yolkytygyfse-a11y/pv-senselab/tests/hardware/README.md

# 硬件验证范围

先完成危害审查与限流方案，依次验证电源/回灌/接地、V/I 量程与静动态标定、PT100 故障、Modbus CRC/超时、MOSFET SOA/热、风扇故障、过流/过温、心跳/复位/断联、物理急停及清洁限位/堵转/互锁。

故障注入方法与注入源须经审查，不直接破坏唯一原型或超出仪表/器件范围。报告每项仪表、接线、条件、冻结阈值、原始日志和结果，未测即标未测。仅独立低压组件；禁止屋顶系统。当前无实测记录。

## 已购物料的前置验证（尚未执行）

- 不接 PV 功率通路，核对开发板、RS485 转 TTL、INA226、MAX31865 的供电/电平，记录 RS485 RO 电平、方向、参考地/隔离与终端，确认后接线。
- SM9569：按实物确认符合手册 DC12–24V 的限流供电与极性；读取实际配置/0x0000 原值，保存 CRC/超时/原帧，不写配置。向厂家确认倍率、响应、误差定义与校准依据后做参考对比。
- SM7820B：按正确手册核对DC5–24V及p.4线序；单独验证实际地址/9600/8N1和FC03双寄存器，再合并不同地址总线。参考核对倍率、负温补码与手册一count冲突、温湿度/故障/无效码；确认前null。验证CRC/异常/超时/迟到/背压/复位，保留原始证据，不自动写配置。
- PT100/MAX31865：类型已确认配套；验证线制/Rref/接触工艺，用标准电阻和温度参考完成两级验证，包含开短路测试，不能仅以有数值作为通过。
- INA226：核对最坏 Voc/Isc 与模块分流/端子/SOA/热/保护条件；先用受限参考源验证零点、增益/非线性、V/I 时间窗与负担，再决定是否适合正式扫描，不能仅凭 50W 标签接入。

2026-10-25 已完成手册内容/来源摘要和 SM9569 示例 CRC 的离线核对；无上电、总线通信、标定、PV 采集或清洁动作结果。

## GPIO 规划 P1 的验证步骤

对主板 INTERFACES.md 的 9 个候选 GPIO 做重复/保留脚/实际引出检查，核对 3.3V 轨、UART RO、I²C 上拉、PT100 线制/Rref 与 RS485 双仪表地址/串口/参考地。按文档分步独立通电并保留成功/失败证据。无 CAN 接线；PV/电子负载/执行器功率回路另审查，纸面检查不代替实物验收。
