yolkytygyfse-a11y/pv-senselab/paper/references/README.md

# 文献与技术资料

当前官方技术入口见 [BOM](../../docs/BOM.md) 以及各规格的对应来源；尚未建立研究文献库。后续核对作者、题名、年份、DOI/链接、实际支持的命题与访问/版本信息。

器件手册在设计冻结时记录版本与摘要；论文引用不得凭记忆捏造，不把官网产品参数作为整机实测证据。受许可限制的全文不随意提交，可保留可访问的索引。
