yolkytygyfse-a11y/pv-senselab/hardware/pv-electronic-load/pcb/README.md

# 负载板 PCB 源目录

当前无 PCB、Gerber 或制造完成记录。必须先完成原理图评审与 TBD-17 机械/加工约束，确认散热器、绝缘/固定、风道和测试点再布局。

重点核对大电流环路、分流 Kelvin、模拟环/门极稳定、热传感位置、急停开断、跨板参考、温升与可触及热表面。提交真实源、DRC/人工审查、BOM/热依据与制造输出的版本关联后才可验收。
