yolkytygyfse-a11y/pv-senselab/hardware/pv-electronic-load/schematics/README.md

# 负载板原理图源目录

当前无原理图。后续保存真实立创EDA工程、版本/库与手册依据、网表/PDF 和审查记录；本文件不代表电路已完成。

绘制前核对 [模块规格](../MODULE_SPEC.md)、[接口](../INTERFACES.md)、线性 SOA/热预算、电源/欠压、硬件限流/过温/急停/心跳、单 FET 短路开断及端点方案。量程、SOA、热耗散、接地、保护和校准全部有依据后才可签核。
