yolkytygyfse-a11y/pv-senselab/hardware/pv-sensing-board/pcb/README.md

# 主板 PCB 源目录

当前无 PCB 或制造文件。待原理图通过评审、PCB 尺寸/层数/铜厚/电流/间距/天线与机械约束（TBD-17）冻结后，在此保存真实立创EDA源与必要审查记录。

布板核对采样 Kelvin、模拟参考、功率/电机回流隔离、USB/RS485 保护、热源距离和校准测试点。制造输出必须绑定源版本、BOM 与 DRC/人工审查；未经审查不生成可投产结论。
