yolkytygyfse-a11y/pv-senselab/hardware/pv-sensing-board/schematics/README.md

# 主板原理图源目录

当前无原理图。后续在立创EDA绘制真实工程并保存到本目录，同时登记工具/库版本、工程 ID、文件摘要和审查结果。禁止放入空白 EDA 文件冒充成果。

绘制前关闭 [模块规格](../MODULE_SPEC.md) 相关 TBD，核对 [接口](../INTERFACES.md)；交付电源树、测量边界、器件手册与引脚核对、量程/误差、保护/接地及校准点。ERC 和人工审查均无阻塞后才能转 PCB。
