yolkytygyfse-a11y/pv-senselab/software/src/pv_senselab/README.md

# Python 代码职责（尚未实现）

计划按实际需要在同一个小包内组织：串口会话与协议校验、追加归档/manifest、任务编排和清洁授权、特征提取及离线分析入口。当前没有 `__init__.py` 或占位函数，不宣称可 import/run。

主机须先准备持久化再 ARM，原始字节优先保存；磁盘失败/背压请求停机且标明未确认设备状态。stop 的安全性不能依赖此包一直运行。scan/action 的 ACK 与终止事件分开处理，清洁不得自动重试。

特征处理保留原曲线和排除理由；模型拟合引用 `models/` 的实现职责与版本，避免创建第二套不可追溯算法。
