yolkytygyfse-a11y/pv-senselab/docs/HARDWARE_SPEC.md

# 硬件总规格与未决项登记册

版本：0.2；日期：2026-10-25；状态：原理图前规格草案，已补充手册核对与采购记录。所有 TBD 均未批准用于接线或上电。

采购核对更新（2026-10-20）：用户报告已购 RS485 辐照度传感器和 50W 光伏板。RS485 已确认，但应用协议/供电未确认；50W 超出本文件原 10–20W 范围。先登记实物与需求差异，待确认是否改用该板；在用户确认并完成相关规格同步与量程、SOA、热/保护重审前，不能视为现有系统已支持 50W，亦不根据功率猜测组件电压/电流。

2026-10-25 更新：已有 ESP32-S3、RS485 转 TTL、INA226、PT100/MAX31865；正确环境手册为 SM7820B V24.3.19，RS485 Modbus、9600/8N1、DC5–24V，温湿度映射已核对；SM9569 为 RS485/DC12–24V。原CAN资料不采用，无需CAN模块。实物电流/电平/线序配置与整链标定仍待核对，50W范围变更未完成。

## 边界与输入包络

唯一被测能源为独立采购的 10–20W 低压光伏组件；绝不连接工厂屋顶光伏。实验电源仅为隔离、限流的辅助供电，电压/电流/接地 TBD。PV 发电与辅助供电分开，不靠被扫描 PV 给主控供电，以免近短路时复位。

必须先拿到组件真实手册，确定额定点、Voc、Isc、温度系数、内部串联数和旁路拓扑。若缺少可信系数，不得臆算最坏值，须获得厂家依据或受控验证后冻结。

| 设计量 | 确定方法 | 当前值 |
|---|---|---|
| PV 额定功率 | 用户边界 | 10–20W |
| 最大运行/允许输入电压 | 冷态 Voc、制造公差、瞬态及元件降额分别核查 | TBD-01、02 |
| 最大运行/允许输入电流 | 高辐照 Isc、温度、容差和接线故障 | TBD-01、02 |
| 最大可吸收功率/持续时间 | 预期 I-V 工作域、失控保持、降额 SOA 与散热 | TBD-03、13、15 |
| 主控、传感、负载模拟环、清洁电源 | 电源树、启动与噪声、USB 回灌与堵转预算 | TBD-04、12 |
| 温度、湿度、户外暴露范围 | 实验环境与器件/连接器约束 | TBD-02、17 |

硬件额定值、软件允许值、硬件跳闸阈值和绝对最大值必须分列。正常运行上限须低于保护门槛且保留误差、瞬态与降额余量，所有数值由计算/测试确定，不把元件绝对最大值当可连续工作值。阈值未配置或标定无效时不得 ARM。

## 测量和控制边界

- 登记的 DUT 输出端作 Kelvin 电压基准：基线为组件与固定夹具输出端，注入损耗时为包含损耗网络的夹具输出端。保存电力线与感测线连接图，不能将该等效边界的参数冒充组件内部参数。电流计量点必须明确是否包括分压/保护漏电和并联故障支路，开路点也须核算测量负载。
- 电流科研测量与负载恒流反馈可共享经过论证的分流链或分设，最终方案 TBD-06、13；无论如何必须分别证明带宽、误差与负担电压。
- 主板向负载提供逻辑 `LOAD_ENABLE`、数字 DAC 设定、心跳，负载回传 `LOAD_FAULT`、保护温度及可选电流/门极状态。物理线、电平、有效极性、上拉归属和 pinout 全部 TBD-05、10。
- SM9569B 辐照度和 SM7820B 温湿度均为 RS485 Modbus 候选，手册默认均9600/8N1、地址1；先逐只核实/配置不同实物地址，再共用现有模块/UART1。电源、接地、电平、终端与保护审查仍须通过。表面状态接口型式 TBD-11。

## 保护与接地要求

| 风险 | 必需设计/审查 | 未来验证 |
|---|---|---|
| PV 反接/误接 | 标识、防误插、反接阻断；量测分压与保护按最坏输入校核 | 限流条件反接及超范围注入，检查无反灌 |
| 过压/瞬态 | 限压、限流与 ADC 输入钳位配合，TVS/RC 型号值 TBD | 钳位电压/漏电/采样恢复记录 |
| 过流/发热 | 本地硬件限流、线缆保护和电源限流，熔断器选型 TBD | 分流、连接器与走线温升和跳闸 |
| MOSFET 失控或短路 | 硬件关断与可切断 PV 吸收通路；独立隔离元件方案 TBD | 强制 ENABLE 失效、短路等受控注入 |
| 过温/风扇停转 | 独立保护测温/比较器与故障锁存；散热器检测不能等同结温 | 温度注入、风扇停转和冷却后人工复位 |
| 复位/断联/软件卡死 | 默认门极释放、ENABLE 禁止、硬件心跳超时、物理急停 | 掉电、主机断开、MCU 复位及卡死模拟 |
| 地回路/共模 | 画 PV、AGND、DGND、功率回路、USB/保护地回路；按测量参考控制汇接 | 接通 USB/辅助电源前后偏置、共模检查 |
| 清洁电机/水/夹持 | 独立驱动和供电支路、续流、限位/堵转/急停；干湿工艺 TBD | 电气互锁、限位异常、堵转/喷液防护 |

PV 是限流源也可能存在危险热故障；不能假定熔断器在所有 PV 故障电流下能断开，须核查动作曲线和可获得电流。急停须切断负载吸收/执行器驱动，保留必要日志供电；最终开断能力和急停拓扑 TBD-10、12、16。

AGND 与功率地按电流路径布局、Kelvin 引线和受控汇接设计，不能生硬切割导致回流跨缝。若采用隔离，电源、数据和测量参考必须一起审查，不能只加数字隔离器就宣称系统隔离。

## SOA、热耗散与 PCB 门槛

负载逐点计算 `P_FET = V_DS × I_D`，分流计算 `P_shunt = I²R`。恒流环卡住时的持续工作也须纳入 SOA；扫描平均功率小不能证明单点安全。稳态先用热阻路径估算结温，瞬态用厂家热阻抗及重复周期评估；散热器、导热界面、环境与风扇故障均纳入。

线性 MOSFET 必须按厂家 SOA 及实际壳温/持续时间降额，不能仅看额定功耗或 Rds(on)。依据：[Infineon 线性模式与 SOA 应用说明](https://www.infineon.com/assets/row/public/documents/24/42/infineon-applicationnote-linear-mode-operation-safe-operation-diagram-mosfets-applicationnotes-en.pdf)。

PCB 尺寸、层数、铜厚、线宽/间距、连接器、固定孔、散热器安装、天线净空、防水与表面处理均 TBD-17。确定电流、温升和加工规则后再绘制 PCB；原理图评审前不生成制造文件。

## 全项目 TBD 登记册

以下是唯一的未决项索引；其他文档引用 ID，状态统一为“待确认”。责任角色尚未分配到具体人，不代表已有负责人。每项冻结须补日期、依据、评审人、版本与验证计划。

| ID | 待确认内容 | 建议责任角色 | 关闭证据 / 依赖门槛 |
|---|---|---|---|
| TBD-01 | 已购 50W 组件，是否改为正式 DUT 待确认；型号、Voc/Isc/系数、低压属性、内部串联数与旁路结构未知 | 实验/硬件 | 用户确认对象范围、实物/铭牌/厂家手册；同步相关规格后再设计量程 |
| TBD-02 | 最坏电气、环境及降额余量 | 硬件 | 组件+环境包络计算；原理图评审前 |
| TBD-03 | 负载功率、持续/脉冲时间、重复占空包络 | 硬件/固件 | 全曲线/失控保持负载表；选 MOSFET 前 |
| TBD-04 | SM9569 DC12–24V 1A、SM7820B DC5–24V 1A手册边界已核对；实际/启动电流、共同12V候选预算、轨/地与防回灌待定 | 硬件 | 实物供电、电流/电源预算与接地图；原理图前 |
| TBD-05 | 原型 P1：I²C 8/9，SPI CS10/MOSI11/SCK12/MISO13，RS485 DIR16/TX18/RX17（按所购模块TX-TX/RX-RX及既有线修正）共线候选；GPIO4/5 不分配，实际板型/引出/占用和电平未核对 | 固件/硬件 | 以主板 INTERFACES 的 P1 为候选，核对实物后冻结；目前未关闭 |
| TBD-06 | INA226 原型模块已购；模块分流/电流额定、I²C 上拉、量程与采样时差未核对，最终 ADC/前端/同步方案待定 | 硬件/计量 | 最坏 Voc/Isc、量程/误差/负担/采样预算与模块审查；原理图前 |
| TBD-07 | 有线主机接口路径、串口参数/吞吐及线缆 | 固件/软件 | 协议吞吐与连接测试计划；固件前 |
| TBD-08 | PT100贴片型、商品2B级已由用户确认，模块图431对应标称430Ω；实际精密Rref/等级标准/贴装/三线补偿支路待核对；SM7820B正确手册/温湿度映射已确认，倍率、标准补码与手册算式冲突、湿度准确度/无效码/响应/校准仍待定 | 计量/硬件/固件 | 实物/厂家澄清、接线、参考验证和整链标定；目前部分关闭 |
| TBD-09 | SM9569 家族手册已核对，B 型为 RS485 Modbus RTU；实际后缀/配置、倍率/响应、线序及校准来源未确认 | 实验/固件 | 厂家确认倍率与电气、实物配置及参考对比；目前未关闭 |
| TBD-10 | 所购RS485转TTL商品图声明TX-TX/RX-RX、3.3V/5V，实接TXD→18/RXD→17；照片MAX485与3.3V声明冲突，实物版本及电平/方向/隔离未知；双仪表共线地址/串口兼容性、pinout、参考地、终端/偏置与线缆未定，无 CAN 采购要求 | 硬件 | 双方接口审查、实物核对、断线/掉电与总线测试；接线前 |
| TBD-11 | 表面状态传感路线、预留口电源/数据型式与保护 | 实验/硬件 | 用途与接口评审；该接口布板前 |
| TBD-12 | 清洁干湿工艺、机械机构、电机/泵、供电与限位 | 机械/硬件 | 清洁方案、堵转与安全分析；执行器设计前 |
| TBD-13 | DAC、运放、MOSFET、控制分流、环路补偿 | 硬件 | SOA、输出摆幅、稳定性与误差预算；原理图前 |
| TBD-14 | 开路隔离、近短路可达电压、端点算法与容差 | 硬件/算法 | 测量负担与参考对比计划；扫描实现前 |
| TBD-15 | 散热器/风扇、热界面、保护测温与结温模型 | 硬件 | 热计算、机械装配与故障工况；PCB 前 |
| TBD-16 | 硬件跳闸、软件边界、急停、租约/心跳/动作超时 | 硬件/固件 | 误差与危害推导、故障测试表；上电前 |
| TBD-17 | PCB 外形/层数/铜厚/布线/净空/防护/散热安装 | 硬件/机械 | 机械图、加工规则与电流/温升依据；PCB 前 |
| TBD-18 | 立创EDA版本、器件库/封装来源与采购渠道 | 硬件 | 官方手册逐脚核对与可追溯 BOM；采购前 |
| TBD-19 | 参考仪表、标准件、标定点/周期和溯源 | 计量 | 仪表规格/证书、校准规程；测量验收前 |
| TBD-20 | 通道误差预算、采样率、同步偏差、稳定性及合格阈值 | 计量/固件 | 静态/动态预算与预实验；正式扫描前 |
| TBD-21 | 因素水平、重复数、随机化、基线与环境匹配窗口 | 实验/统计 | 预实验方差、功效/区间精度与预注册方案；正式实验前 |
| TBD-22 | 参数边界/先验、可辨识与模型失配判据 | 模型/统计 | 灵敏度、多初值与参考数据方法评审；估计验收前 |
| TBD-23 | 诊断标签、拒识、评价与清洁触发/恢复判据 | 实验/模型 | 标签来源、独立划分与配对统计方案；闭环前 |
| TBD-24 | 数据归档/备份位置、容量、保留和恢复要求 | 数据管理 | 可恢复演练、权限与清单；采集前 |
| TBD-25 | 当前台架已采用 Arduino-ESP32 3.3.11、Arduino CLI 1.5.1；Python 工具仅标准库，正式部署/框架与环境仍待验收 | 软件/固件 | 真实构建和环境记录已提供，实物复现/正式选型仍待验证 |
| TBD-26 | 台架实现 191 字节命令、2048 字节行缓冲/8 行输出队列、约 1 秒主机 fsync；正式 JSON 协议重试/去重及全部吞吐/掉电/重连预算仍待验收 | 软件/固件 | 当前参数为实现选择，不是实测性能；正式压力/断电与恢复测试后冻结 |

原型接线规划已补入 [主采集板接口表](../hardware/pv-sensing-board/INTERFACES.md)。GPIO 的设计选择不表示未知模块针脚/电平已确认；保留 TBD 的是实物适配和放行条件，不是让后续代码另选一套默认引脚。共享 DC12V 为两份手册范围交集下的供电候选，实际电源预算、隔离/参考地及所有保护仍须核对。

## 上电前交付物

立创EDA真实工程、双方 pinout、关键器件手册、量程与误差预算、SOA/热表、接地与保护审查、校准注入点、限流上电步骤、故障用例和有效的配置版本缺一不可。本阶段上述电路成果均未完成；两板模块详见 [hardware](../hardware/README.md)。

2026-10-25用户确认SM7820B外置供电12V；这是用户报告的名义值，不是电源纹波/启动电流/限流和接地验收。TTL模块VCC仍3.3V，12V不接ESP32或TTL逻辑电源；TBD-04/10其余门槛保留。
