yolkytygyfse-a11y/pv-senselab/hardware/pv-electronic-load/MODULE_SPEC.md

# 电子负载板电路模块规格

版本：0.1；日期：2026-10-20；状态：设计输入，未实现。

## 电路模块与关键器件

| 模块 | 设计功能 | 关键器件/参数 | 审查要求 |
|---|---|---|---|
| PV 功率入口 | 防误接、反接/瞬态与可断开通路 | 连接器/阻断/开断/保护 TBD | 电压、电流、开断与接线故障，勿假定 PV 必能熔断 |
| 数字设定 | 主板 SPI→模拟电流设定 | DAC/基准 TBD-13 | 上电默认、输出范围/分辨率/漂移、通信失效 |
| 本地恒流环 | 设定与分流反馈比较→门极控制 | 运放、分流、补偿 TBD-13 | 共模/摆幅、近短路余量、环路稳定与限流优先级 |
| 功率吸收 | 将 PV 功率转成热 | 线性 SOA 合格 MOSFET 型号/数量 TBD | 每点及失控保持的 Vds/Id/温度/持续时间 |
| 热管理 | 散热与保护回读 | 散热器/界面/风扇/测温 TBD-15 | 热路径、风扇失效、安装误差、热滞后 |
| 硬件保护 | 过流/过温/急停/心跳超时→禁止门极并开断 | 比较/锁存/看门狗/开断 TBD-16 | 不依赖 MCU 软件；单个 FET 短路不能让急停失效 |
| 端点与反馈 | 开路隔离、近短路能力、断开/温度/故障回读 | 方案 TBD-14 | 漏电、最小压降、状态反馈和校准可达性 |
| 辅助供电 | 模拟/保护供电不受 PV 扫描坍塌影响 | 电源轨/稳压 TBD-04 | 欠压时门极安全释放、防向主板回灌 |

## 模拟环验算

理想设定关系可写为 `I_set = V_set/(G_feedback × R_control)`，最终必须加入增益/偏置、输出摆幅、负担与动态误差；G/R/范围均 TBD，不以理想式承诺精度。DAQ 计量与控制反馈分设/共享方案按误差和接地预算决定。

在 DUT 从 Voc 到近零电压的工作域检验运放共模/输出、MOSFET 门极驱动与控制余量。评估电缆电感、输入电容、分流位置、门极电容对环路的影响，实测阶跃和振荡，不凭补偿经验认定稳定。

## SOA 与散热预算交付

- 每个代表工况列 V_DUT、I_DUT、V_DS、P_FET、分流损耗、单点时长、重复周期、环境/壳温；扫描卡死或连续保持单点按持续条件验证。
- 型号必须有适合线性使用的 SOA 证据，并按厂家方法对壳温和持续时间降额；不能把开关器件额定电流/功耗当线性能力。
- 估算 `Tj ≈ Ta + P × (RθJC + RθCS + RθSA)` 的适用性，瞬态用热阻抗、多热源用相应热网络；记录风扇故障及温度传感滞后。
- 并联 MOSFET 不能默认均流；若必须并联，需证明热稳定/均流并增加相应验证，优先足够且最简的方案。
- 阈值、迟滞、锁存/复位与可触及表面温度要求 TBD-15、16，未冻结不得上电验收。

## 故障与端点

LOAD_ENABLE 无效、主板/负载供电丢失、硬件心跳超时、温度/过流异常或急停均立即禁止吸收，锁存故障并给出反馈。门极有明确泄放/钳位；若功率 FET 短路，独立开断路径仍应能停止吸收。默认安全态与具体极性 TBD，必须在原理图逐项核对。

零设定不等于真正开路，完全导通不等于零伏短路。端点按 [IV_TRACER_SPEC](../../docs/IV_TRACER_SPEC.md) 资格判定；未验证低压能力时只报告近短路或外推值。任何硬短接支路要另行审查，不在本阶段默认存在。

## 接地、保护与标定

功率回流避开分流 Kelvin 和模拟参考；设定、保护阈值及回读考虑跨板地偏移。分流采用合适端接并测温漂，预留标准电流/电压注入和测试点。外接电阻损耗夹具的并联支路也需独立安全断开，不能依赖关闭本板来处理其发热。

未来验收包括量程、线性 SOA、热耗散、接地、保护和校准；先用限流参考源低风险验证，再逐步接入真实组件。当前无任何可吸收功率、稳定性或精度实测结论。
