yolkytygyfse-a11y/pv-senselab/hardware/pv-sensing-board/INTERFACES.md

# 主采集板逻辑接口表

版本：0.3；日期：2026-10-25；状态：逻辑接口及用户委托的原型 GPIO 规划，实物接线未验收。下文 GPIO 是有依据的设计候选，不能视为已确认开发板引出或模块针脚；连接器料号、物理针号、电源轨/电平及其他控制信号仍 TBD-04、05、10。`输入/输出` 相对主板；端口名为功能名而非已存在丝印。

| 功能端口 | 信号 | 方向 | 电气/默认态要求 | 关键依赖 |
|---|---|---|---|---|
| PV 计量 | DUT_V+ / DUT_V-；电流路径/分流 Kelvin | 输入 | 仅独立低压 DUT；端子取样与支路拓扑登记；量程 TBD | 01、02、06 |
| 辅助供电 | AUX_IN / RETURN | 输入 | 反接、限流、防回灌；不与 PV 端混插 | 04、10 |
| 主机 | USB 数据及供电边界 | 双向 | 原生/桥接 TBD；检查 USB 地和双源供电 | 04、07 |
| PT100 外接口 | RTD 激励/感测线 | 输入/激励 | 线制/针数 TBD，禁止套用未核对模块接线 | 08 |
| MAX31865 内部接口 | SPI CLK/MOSI/CS、MISO、DRDY（如用） | 输出/输入 | 与实际器件时序/供电一致，CS/启动态审查 | 05、08 |
| 环境温湿度仪表 | SM7820B，共用RS485 A/B、参考地与独立供电边界 | 双向/电源 | 手册DC5–24V、9600/8N1；实际线序/地址/电平/接地与电源预算核对后共线 | 04、08、10 |
| V/I 原型模块 | INA226 I²C SDA/SCL、逻辑供电/参考地；功率测量端另核对 | 双向/输出 | 原型候选，核对模块上拉、分流、端子电流与最坏 Voc/Isc；无冻结物理针号 | 02、06、10 |
| 辐照度 | RS485 A/B、参考/屏蔽、供电（如提供） | 双向/待定 | 总线终端/偏置统一，厂家 A/B 核对，防浪涌 | 09、10 |
| 表面预留 | SURFACE_DATA / POWER / RETURN | TBD | 接口用途和电气冻结前不得接设备 | 11 |
| 负载设定 | LOAD_SPI_CLK / MOSI / CS；MISO（可选） | 输出；MISO 输入 | DAC 位于负载板，上电未知值不得解除禁用 | 10、13 |
| 负载许可 | LOAD_ENABLE | 输出 | 主板复位/掉电/断线必须禁止吸收；极性 TBD | 10、16 |
| 安全心跳 | LOAD_HEARTBEAT | 输出 | 负载板本地硬件看门狗检测；静态电平不能维持许可 | 10、16 |
| 负载故障 | LOAD_FAULT | 输入 | 锁存/断线检测、上拉归属和极性 TBD；同时参与硬件禁用 | 10、16 |
| 负载温度/反馈 | LOAD_TEMP / LOAD_OFF_FB；可选电流回读 | 输入 | 型式/范围 TBD；断开反馈必须足以支持清洁互锁 | 10、15、16 |
| 清洁控制 | CLEAN_ENABLE / CLEAN_COMMAND | 输出 | 默认停机；动作型式/电平 TBD | 12、16 |
| 清洁反馈 | CLEAN_PARKED / LIMIT / CLEAN_FAULT | 输入 | 位置与故障可检查，断线安全；不得仅凭延时猜停驻 | 12、16 |
| 急停 | ESTOP_PERMIT / 状态回读 | 输入及硬件链 | 物理回路失效应失去许可，不仅由软件读取 | 10、12、16 |

与 [负载板接口](../pv-electronic-load/INTERFACES.md) 逐条交叉审查。近短路/输入开断路径归属在 TBD-14 冻结后追加，不私自占用 GPIO 或填入常见针脚。跨板模拟温度/电流回读须另核对输入保护、噪声与地参考。

现有 RS485 转 TTL 型号未知：先核对供电、TTL 接收输出电平、自动方向或 DE/RE、参考地/隔离和终端/偏置；不能仅凭“TTL”假定适配 ESP32。SM9569 手册模拟输出接线不用于指定 RS485 线色；SM7820B p.4图示红电源+、绿电源−、黄A+、蓝B−；线色按原厂引线核对，不套用于SM9569或其他版本。

## 原型 GPIO 规划 P1

用户于 2026-10-25 确认尚未连线，并委托规划。以 [ESP32-S3-DevKitC-1 v1.1 官方引出表](https://documentation.espressif.com/api/resource/path/docs/projects/esp-dev-kits/en/latest/esp32s3/esp32-s3-devkitc-1/user_guide_v1.1.html) 和 [ESP32-S3 引脚约束](https://docs.espressif.com/projects/esp-idf/en/v5.3.3/esp32s3/api-reference/peripherals/gpio.html) 为参考；用户只确认 ESP32-S3 开发板，未确认就是此型号。GPIO 编号不是排针顺序或其他板型的 D 编号；实际板上相应引出和占用须核对，未引出/已占用时不能强行套用。

本规划采用 9 个互不重复的 GPIO（自动方向时 8 个），GPIO4/5 不分配；不占 GPIO0/3/45/46 启动脚，保留 GPIO19/20 USB、GPIO43/44 默认串口、GPIO26–37 存储器潜在占用及 RGB 候选 GPIO38/48。以实际板型为准。

| 功能/程序符号 | ESP32-S3 GPIO | 对端逻辑信号 | 方向/条件 |
|---|---|---|---|
| INA_SDA | GPIO8 | INA226 SDA | 双向；上拉只能到已核对的 3.3V 逻辑轨 |
| INA_SCL | GPIO9 | INA226 SCL | 主控时钟；核查已有上拉，不重复盲加 |
| RTD_CS | GPIO10 | MAX31865 CS | 主控输出，启动应保持非选中 |
| SPI_MOSI | GPIO11 | MAX31865 SDI / MOSI | 主控输出到转换器输入 |
| SPI_SCK | GPIO12 | MAX31865 SCK / CLK | 主控时钟 |
| SPI_MISO | GPIO13 | MAX31865 SDO / MISO | 转换器输出到主控输入 |
| RS485_DIR | GPIO16 | 手动方向模块的 DE 与 /RE 联接点 | 条件分支：常规 DE 高有效、/RE 低有效时，低接收/高发送；自动方向模块不连接此 GPIO |
| RS485_TX | GPIO18 | 所购四针模块 TXD（商品页定义为主控发送输入） | UART1 TX 输出；仅本次所购模块定义，不推广其他版本 |
| RS485_RX | GPIO17 | 所购四针模块 RXD（商品页定义为主控接收输出） | UART1 RX 输入；核对模块输出电平，5V 输出不得直接连接 |

MAX31865 DRDY 和 INA226 ALERT 首版不分配 GPIO，按实际采集设计轮询/读取状态；不得把未分配口默认接到任意脚。负载/清洁/急停等控制仍是独立 TBD，本表不启用任何功率动作。后续固件须显式采用此表，不能依赖不同 Arduino 开发板变体的默认 I²C/SPI 引脚。

## 电源、地与端子边界

1. **主控**：台架原型先用 USB 给 ESP32-S3 供电。外部工业传感器电源不接开发板 5V/3V3，也不同时向未知电源路径的板外部注入 5V。参考板官方列出互斥的供电路径，实际板须按其电路核对。
2. **低压逻辑模块**：INA226 芯片和 MAX31865 芯片允许 3.3V 工作，但模块 VIN/VCC 可能经过稳压或电平转换，须确认所用端子支持 3.3V 直接供电。模块供电、I²C 上拉和逻辑电平全部核对后才接开发板 3V3；不保证未知模块的 5V VIN 端在 3.3V 下正常。核算开发板稳压器余量，不能用 3V3 给工业传感器供电。
3. **工业传感器**：SM9569手册DC12–24V，SM7820B正确手册DC5–24V；稳定DC12V可作共同候选，实际允许范围/启动电流/总预算/余量/极性/限流与保护审查后才供电，当前电源树TBD-04。工业电源不接ESP32的3V3/5V或信号脚；不得将“1A”当实测耗电。
4. **参考地**：非隔离台架在核对电源隔离/USB 回路后，用受控汇接点连接主控 GND、模块逻辑 GND 和外部传感器参考地。不要把外壳/屏蔽/保护地当作信号参考地。若选隔离收发器，分别设计两侧电源与地，不为套用共地规则跨接隔离屏障。
5. **RS485 物理侧**：单模块 A/B 经主干分别连接两只仪表已确认的 A/B，支线尽量短；参考地/隔离按核对方案。共同 9600/8N1、应用协议兼容且各实物地址唯一后才合并；先逐只连接，程序只改查询地址不改仪表地址。终端/偏置按总线两端与既有配置统一，不能每个节点盲加。方向控制/线色/供电针脚按实物核对。
6. **总线方案限制**：不配置 CAN、不采购 CAN 收发器。若温度仪表协议/串口参数不能兼容现有总线，则另设 RS485 总线并重新规划 GPIO/模块/固件，不强行共线。
7. **PT100 端子**：SPI 四线按表规划，探头到 MAX31865 的端子连接另按实际 2/3/4 线和模块跳线说明确定。不能把任意两线接到四端口就宣称三线补偿；线数、同端引线判定、参考电阻名义/实测及固件线制必须一致。不虚构线色与 Rref。
8. **INA226 功率侧**：本次只规划逻辑口，IN+/IN-/VBUS 的模块连线和 PV 功率路径在最坏 Voc/Isc、分流额定/温升、测量平面及保护审查后另定。INA226 不是电子负载。50W 组件范围变更未完成，不能据逻辑口表接入或用面包板/杜邦线承载其功率通路。

## 分步核对与放行

先断电核对板型/端子、短路与极性 → USB 启动主控 → 核对逻辑电源/电平后接 INA226 → 按线制接 MAX31865/PT100 → 独立核对两只 RS485 仪表供电/参考地/协议/地址/速率 → 分别测试原码 → 满足共线条件后合并轮询。每步保留接线、配置、错误与原始读数；环境工程换算按SM7820B倍率/负温核对状态，SM9569 倍率按 SENSOR_SPEC/API_PROTOCOL 处理。

量程：芯片和模块电气边界核对未完成；SOA/热：逻辑模块稳压及驱动额定需检查，PV/电子负载功率阶段不在本次放行范围；接地：检查单点汇接及隔离；保护：电平、防回灌/短路、端子极性；校准：INA226 分流/参考与 PT100/Rref，以及环境仪表参考对比均待执行。当前只完成纸面规划，无通电、通信、标定或安全验收通过记录。

固件初始化检查补充（2026-10-25）：Arduino-ESP32 3.3.11 的 digitalWrite 仅对已注册GPIO生效；CS必须先 pinMode(OUTPUT)，再置HIGH，随后初始化SPI，避免配置总线时器件已被选中。手动RS485方向同样先配置输出再置接收态。此顺序修正不改变P1引脚，不代替CS外部上拉与上电波形验证。

## 所购RS485模块证据与冲突（2026-10-25）

用户确认实接模块TXD→18、RXD→17、VCC→3V3、GND→主控GND；随后提供商品接线图，明确TX-TX、RX-RX直连，VCC标3.3V或5V。据此0.4.1修正主控UART为TX18/RX17，四针自动收发模式不连DIR；不要求用户先拆换现有线。半双工说明同一A/B对先发后收，不能单凭半双工判断TTL端TXD/RXD的丝印视角。

产品图8脚芯片可辨MAX485、14脚CD4069；实际芯片/PCB修订与引脚电气仍TBD。公开[同外观板逆向资料](https://www.circuitstate.com/pinouts/max485-cd4069-rs-485-module-with-auto-data-direction-control-pinout-diagram-and-pin-reference/)把TXD定义为输出，和用户所购页面相反，不能凭外观替代实物核对。[MAX485厂家资料](https://www.analog.com/media/en/technical-documentation/data-sheets/MAX1487-MAX491.pdf)规定5V±5%，不保证3.3V工作；[CD4069UB资料](https://www.ti.com/lit/ds/symlink/cd4069ub.pdf)也不能替代整板电平说明。商品3.3V声明不关闭TBD-04/10。保持当前3.3V作受限诊断，不擅自改5V；5V供电若无输出限压/输入阈值论证，不能直接连接ESP32。

量程/保护：双向TTL电平及瞬态、短路/反灌和A/B共模待测；SOA/热：模块供电与保护元件额定未验收，无PV功率动作；接地：主控与模块GND用户已确认，传感器参考地和USB回路仍待核对；校准：串口波特/波形与测量链仍未验收。当前通信失败记录不证明唯一根因。

实测更新：TX18/RX17后收到CRC有效温湿度帧，支持所购商品页的引脚视角；并未证明其他同外观版本定义。存在UART启动首事务超时，模块供电/时序/波形原因未分离；未完成电气放行。一次固定改址写入未确认，后续只读仍在1号应答，不能把仪表当2号重新共线。证据见tests/integration/README.md及todo.md。

后续实测成功记录：用户确认环境传感器12V；15连续读回旧址寄存器1，维护增至100ms保守间隔后16严格读回2号0x66=2，17在2号读取普通数据、1号两次无应答。0.4.6主站默认查询2，前述“仍1/不能当2号”是较早失败记录，已由本条新证据更新。辐照度当前未复查、双仪表共线/断电保持及电气/标定验收仍未完成。

双从站恢复后19记录：2号地址寄存器仍2、1/2号均可读，但约10ms事务空闲下2号出现5次超时。0.4.7仅调整总线空闲为100ms作对照，不改变供电/引脚、保护或校准方案，不把该软件缓解措施当硬件电平/接地/热验收。

同接线20复查：仅将普通事务空闲改100ms后，两仪表约20秒各21/21帧有效；2号地址检查首笔仍有timeout，后3笔值2。此改善支持台架保守间隔方案，不证明唯一硬件根因、最小间隔或3.3V电平/SOA热/接地保护验收；原始证据见tests/integration/README.md。

0.5.0参考模式保留现有3根探头物理线，仅显式关闭MAX31865 D4补偿位，记录物理线3/补偿false/未补偿质量标志。用户报告在板Rref428Ω非精密校准，原码8388–8391对应参考24.55–24.65°C（31）；不宣称标准三线补偿放行。此次无量程/供电/引脚/接地/保护/激励或热占空改变，无SOA功率动作；原有电气与校准TBD仍保留，不继续割焊。
