yolkytygyfse-a11y/pv-senselab/hardware/pv-sensing-board/MODULE_SPEC.md

# 主采集板电路模块规格

版本：0.1；日期：2026-10-20；状态：电路设计输入，非已完成原理图。

## 模块和关键器件

| 模块 | 输入→输出 / 职责 | 关键器件路线 | 设计要求与未决项 |
|---|---|---|---|
| 电源入口 | 辅助供电→各逻辑/模拟轨 | 反接/限流/稳压/滤波 TBD | 主控不靠被测 PV 供电；启动、电机干扰、USB 回灌 TBD-04 |
| 主控/调试 | 采集与控制→有线数据 | ESP32-S3 模组 TBD | GPIO 电平/复用/启动脚、Flash/调试连接 TBD-05、07 |
| 电压计量 | DUT Kelvin 电压→受保护 ADC | 精密分压、RC、ADC/基准 TBD | 冷态 Voc/瞬态覆盖、钳位漏电、开路加载与标定 TBD-02、06 |
| 电流计量 | 净输出支路电流→ADC | Kelvin 分流/放大器 TBD | 负担、功耗、热漂移、共模、V/I 时差 TBD-06、20 |
| 组件温度 | PT100→SPI 原码/状态 | PT100、MAX31865、Rref TBD | 线制/故障检测、Rref、接触和自热 TBD-08 |
| 环境温湿度 | SM7820B→RS485原帧/温湿度 | 正确手册Modbus，优先共用既有模块 | DC5–24V、9600/8N1、双字映射；实际配置、倍率/负温/电源预算、防直射/响应/校准TBD-08、10 |
| 辐照度接口 | RS485 Modbus→W/m² 原始帧与换算 | RS485 收发/保护/终端 TBD | 仪表供电/寄存器/接地与隔离 TBD-09、10 |
| 表面预留 | 未定义表面观测→未来接口 | 连接器/保护 TBD | 不先假设电压或传感类型 TBD-11 |
| 负载控制 | SPI 设定+许可/心跳→负载；接收故障/健康 | DAC 在负载板，主板逻辑和回读 TBD | GPIO 默认态、断线诊断、独立硬关断 TBD-10、16 |
| 清洁接口 | 驱动许可→独立驱动；限位/故障返回 | 逻辑接口、驱动在执行模块 | 不直接驱动大电流，互锁/停驻/堵转 TBD-12 |

## 测量拓扑

DUT 输出电压在连接端子 Kelvin 取样，电流在指定净输出支路计量；负载控制分流位置另行论证。注入外置电阻时 DUT 包括夹具网络，原理图和接线元数据要标清测量平面与并联支路，不能只改标签而不改电压取样位置。

ADC 输入范围、分压比、滤波截止、基准与有效采样率均 TBD。完整误差链包含线缆/连接器、ADC 建立、通道切换、温漂和 V/I 同步，不以器件标称位数作精度结论。片内 ADC 是否足够须实测论证；外置方案为优先候选而非已选器件。

用户已有 INA226 模块，可用于经过量程/分流/电平审查后的原型采集；芯片 0–36V 边界不代表模块安全电流或高精度扫描已验证。主板最终前端暂不冻结为 INA226。RS485 环境与辐照度在相同串口参数/不同实物地址/协议兼容条件下共用 UART1；PT100 为 SPI，INA226 为 I²C，GPIO/供电与地/保护仍 TBD，不能把传感器工作电压引入 MCU 信号端。

## 保护、接地与测试点

1. 输入反接/瞬态不得把过压送入 ADC、SPI 或 MCU；考虑主板掉电但 PV 仍有电的回灌路径。
2. AGND、DGND、负载功率地和执行器回流按电流路径设计并控制汇接；USB 接地和隔离边界先画出，不假定共地无影响。
3. RESET/启动脚不可造成 LOAD_ENABLE 或 CLEAN_ENABLE 有效。急停与负载板故障必须能硬件禁用；心跳独立于主机分析软件。
4. PT100 断/短路、RS485 超时、ADC 饱和均须可检测和记录；关键通道失效阻止 ARM/触发停机。
5. 测试点覆盖电源轨/地、ADC 前后、Rref、分流 Kelvin、ENABLE/FAULT/心跳、SPI 和 RS485；实际位置与注入方式 TBD，不给出未经核算的引脚。

## 原理图评审验收

提交各轨启动/电流预算、逐通道量程/误差表、接地与输入保护计算、pin map、符号/封装核对、标定注入及限流上电步骤。六项检查必须记录：量程、SOA（含保护开关适用工况）、热耗散、接地、保护、校准。本阶段无审查通过或测量精度结论。
