yolkytygyfse-a11y/pv-senselab/docs/ROADMAP.md

# 七周研发路线图

版本：0.1；日期：2026-10-20；状态：资源与关键参数未冻结的计划，不承诺七周一定完成。按相对周次排列；起始日期、人员、预算、器件交期/加工能力 TBD。所有里程碑必须有真实证据，未过门槛顺延，不以伪造数据或跳过保护补进度。

| 周次 | 工作范围 | 交付物 | 周验收标准（需全部满足） | 依赖/阻塞 |
|---|---|---|---|---|
| 第 1 周 | 初始化、需求/系统规格、风险与 TBD | 当前目录、十份规格、AGENTS/todo、接口草案与路线 | 文件/链接/忽略规则检查通过；R01–R11 均有规格和验证路径；未完成能力明确；项目负责人评审需求，指定 TBD 关闭责任 | **本次仅完成结构和规格部分；评审及参数冻结尚未完成** |
| 第 2 周 | 两板选型、立创EDA原理图与评审、PCB 约束 | 真实 EDA 源、BOM 版本、接口 pinout、电源树、量程/误差/SOA/热/接地/保护计算；通过门槛后 PCB | TBD-01–18 中影响本次电路的项目已冻结；逐脚核对/人工审查及 ERC 无未处理阻塞；故障断开与校准测试点明确；PCB 加工规则有依据 | 无组件手册/供电/线性 SOA 依据即不得签核；制造采购延迟须记录 |
| 第 3 周 | 硬件到货、分段限流上电、采集链与保护标定 | 上电日志、参考仪表、原始标定及误差预算、故障注入记录、归档恢复演练 | 反接、掉电/复位/断联、急停、过流/过温及关键传感故障按安全方案验证；测量误差符合事前冻结预算；TBD-19、24 已关闭 | PCB/器件未到不得声称样机通过；仅台架部分通过须明确覆盖范围 |
| 第 4 周 | 最小固件与 Python 有线数据链、自动扫描/特征 | 可构建固件、真实 CLI、协议/记录校验、真实 I-V/P-V 及参考对比 | 协议坏帧/幂等/背压/断联验证；原码和时间/标定引用可重放；端点资格明确；扫描重复性/误差符合已冻结 TBD-14、16、20、25、26；异常安全停止 | 无标定/端点证据不能声称 Voc/Isc/FF 直接合格 |
| 第 5 周 | 单二极管正向与估计、辨识性/诊断方法基线 | 版本化算法、真实曲线分析、残差/灵敏度/多初值/区间和失败报告 | 可从原始记录复算；参数边界/先验/权重明确；给出不可辨识/失配拒识；无真值时披露参数误差不可直接求得；TBD-22 冻结 | 用已验证流程开展预实验，不将探索性结果冒充独立验收 |
| 第 6 周 | 冻结并执行因素/组合实验、清洁闭环 | 实验规程与标签、对照/重复记录、授权动作和前后曲线、恢复评价 | TBD-12、21、23 正式冻结；因素记录/混杂控制/排除规则完整；互锁与失败保留；复测环境匹配或明确拒绝归因；不以“必须恢复”为验收门槛 | 样本量不足则补实验或降级为探索性，不能虚报统计结论 |
| 第 7 周 | 独立复测、误差整合、复现归档与论文 | 发布候选工程快照、可恢复数据包、环境/版本清单、可追溯图表、论文草稿 | 独立运行按冻结方案评价；第三方/另一环境能按步骤复算指定结果；图表指向源记录；失败/局限/不确定度完整；未完成项如实列出 | 论文录用、诊断效果或清洁收益不是可预先承诺的里程碑 |

## 跨周门槛

- **设计门槛**：相关 TBD → 原理图评审 → PCB/采购，不先加工后补保护计算。
- **通电门槛**：限流电源、量程与接地/保护审查 → 分段低风险上电 → 故障验证 → 接真实组件。
- **测量门槛**：原始归档/备份与标定有效 → 静态/动态预算冻结 → 正式扫描。
- **科学门槛**：预实验 → 正式规程/评价阈值冻结 → 独立实验 → 结论，不能反向调阈值迎合结果。
- **动作门槛**：负载断开反馈 + 停驻/限位/急停检查 + 有效本次授权 → 清洁 → 环境稳定 → 重新 ARM/复测。

## 周评审记录要求

每周在 `todo.md` 记录实际完成项、证据路径、失败与阻塞、已关闭 TBD 及后续工作。设计目标、厂家数据与实测结果分栏。凡未执行的验证标“未执行”，不得以 README、计划或示意图代替运行结果。

第一阶段本次验收只对应第 1 周的结构/规格交付；它不意味着第 1 周全部门槛或整个七周工程完成。

2026-10-25 进展补充：按用户追加要求已提前实现 Arduino 只读台架采集与电脑归档，并完成软件测试/目标编译。第 4 周所列正式协议、I-V 扫描、参考对比和保护/标定门槛仍未通过；该实现不是第 4 周或整机验收完成。
