yolkytygyfse-a11y/pv-senselab/models/README.md

# 物理约束模型

状态：研究规格，未实现算法/训练/验证，无估计结果。

主线为 [single_diode](single_diode/README.md)。研究正向曲线、受约束参数估计、可辨识性与误差传播；诊断允许拒识。方法和方程以 [实验计划](../docs/EXPERIMENT_PLAN.md) 为准，输入输出以 [数据字典](../docs/DATA_DICTIONARY.md) 为准。

不预先搭复杂机器学习平台。估计 Iph/Rs/Rsh 等不等于能唯一识别损伤机理；遮挡多峰等失配必须记录，不因“物理约束”而承诺准确。模型代码最终位置与安装入口在首次实现时统一确定，避免研究脚本/软件包双份维护。
