yolkytygyfse-a11y/pv-senselab/paper/README.md

# 论文成果

当前仅组织结构，无实验结论或已完成论文。

- [manuscript](manuscript/README.md)：问题、方法、结果与局限的论文源。
- [figures](figures/README.md)：可追溯的图表与源记录索引。
- [references](references/README.md)：实际核对的文献元数据和引用。

贡献须以真实硬件/软件/实验为依据。方法计划可以先写，结果只能来自有原始数据/标定/分析版本的记录；不承诺诊断准确率、参数精度、恢复收益或录用。不要把等效损耗实验外推为未经验证的长期老化结论。
