yolkytygyfse-a11y/pv-senselab/data/interim/README.md

# 中间处理产物

未来保存保留来源的解码/标定换算/质量检查和选点结果，记录源摘要、处理版本、配置、排除表与 analysis_id。无效点的原因在派生表标记，不能从原始文件删去。

除本说明默认 Git 忽略，能够从原始归档与版本化配置重建；当前无处理产物。
