yolkytygyfse-a11y/pv-senselab/data/metadata/README.md

# 实验元数据

未来登记组件/设备/传感器/夹具 ID、手册版本、额定和最坏包络、测量平面、接线照片索引、软硬件配置、clock_sync 映射索引、数据文件 SHA-256 和归档位置。

元数据修正有版本和原因，旧记录保留。不得提交密钥或以猜测补齐器件信息；未知项为 null+原因并链接 TBD。当前已登记用户报告的物料及手册来源，尚未建立包含序列号/实物照片的正式设备档案。字段语义以 [数据字典](../../docs/DATA_DICTIONARY.md) 为准。

## 手册来源核对（2026-10-25）

原始 PDF 位于用户提供的外部路径，均未修改或复制入仓库；摘要用于辨认本次读过的版本，后续按数据归档规则保全。误发论文按用户要求忽略，不登记为技术来源，不保留其内容到项目。

| 文件 | 标题/版本 | 页数 | SHA-256 |
|---|---|---|---|
| SM9569.pdf | SM9569 产品使用手册，V23.10.14；RS485 对应 SM9569B | 9 | be23f30cd3aa451c952e56b81c80cb8d4eded3544f56c2973b523b1d0de87345 |
| SM7820C (1).pdf | SM7820C 金属防护型 CAN 总线温湿度传感器，V26.5.28 | 9 | a1db8ff721e4f78df800bfeac1a908c7fd89b0d492ccc050e96d151273d3da7a |

已提取全文并目视核对相关页，SM9569 示例 CRC 仅离线核对，无设备返回数据。用户后续明确环境仪表是 RS485；上表 SM7820C 为 CAN 版本，仅留资料追溯，不用于当前电气/协议/倍率，不能由家族名称猜 RS485 型号。正确环境手册待补。SM9569 倍率仍未明。采购报告、手册、实物核对与实测校准分别记录。

## 正确 RS485 手册补充（2026-10-25）

用户确认 SM7820B.pdf（外部原件未修改）为当前设备手册：V24.3.19，10页，SHA-256 `81eff1f92eeb72c847756ec7a433dc9b13f1c77750fcca1c8e9bbb7c29f20267`。已提取全文并目视核对 p.4 接线及 p.7–8 协议/寄存器/负温说明。确认 RS485/Modbus、9600/8N1、地址1及双温湿度寄存器；倍率假设措辞、负温减65535错误和响应示例冲突见 SENSOR_SPEC。该手册取代当前环境接口的CAN资料，不取代实物配置/参考验证。
