yolkytygyfse-a11y/pv-senselab/data/processed/README.md

# 分析产物

未来保存特征摘要、受约束参数/区间/辨识性、诊断/拒识、清洁恢复结果及图表数据。每项包含 analysis_id、源 scan_id/文件摘要、算法/配置版本、误差和适用性。

除本说明默认 Git 忽略，论文/发布所需结果通过明确清单归档。没有真实数据不能生成看似实测的曲线、准确率或恢复率。当前无分析结果。
