yolkytygyfse-a11y/pv-senselab/data/raw/README.md

# 原始数据

未来路径：`<experiment_id>/<run_id>/`。保存 manifest、原始接收字节分块、解析后保留原码的测量 JSONL、事件和附件，字段见 [数据字典](../../docs/DATA_DICTIONARY.md)。解析失败帧和故障也保存。

只追加/冻结保留；任何校正和重处理另存，不覆盖。除本 README 默认 Git 忽略，采集前必须有独立归档与恢复方案（TBD-24）。当前无数据文件，不能从本目录推断已有实验。
