yolkytygyfse-a11y/pv-senselab/models/single_diode/README.md

# 单二极管研究职责

计划参数化为 Iph、I0、Rs、Rsh、a；a=n·Ns·kT/q。Ns 和 Tcell 无独立信息时不同时自由估计 n/Ns/Tcell。背板温度代理偏差、DUT 夹具边界、测量不确定度均要进入解释。

后续先验证数值正向求解，再实现最简足够的受约束估计；每次输出来源、边界/先验、固定参数、初值、残差、多初值、灵敏度、区间、失配与辨识状态。未知参数真值时不报告伪绝对误差。

当前无代码、参数文件、合成样本或拟合图。相关判据在 TBD-22 冻结后实施，结果独立保存到 `data/processed/` 而非覆盖原始测量。
