yolkytygyfse-a11y/pv-senselab/software/configs/README.md

# 配置管理

当前无可直接上电使用的配置。未来分开记录硬件/通道映射、安全限制、标定引用、扫描序列和实验/分析参数，保持最少必要文件。

所有配置必须有 config_id、schema 版本、适用硬件/固件及审查状态。TBD 值、缺失阈值、未知 GPIO 或未标定通道不得落成“默认可运行配置”。密钥不入库；本地路径和数据归档位置按实际环境填写。配置修改同步数据字典与验证步骤，不静默放宽安全门槛。
