yolkytygyfse-a11y/pv-senselab/paper/figures/README.md

# 论文图表

未来每幅图保留生成代码/命令、analysis_id、源摘要、配置版本、坐标单位、误差条含义与样本结构；生成源与正式图绑定版本。概念图明确标为概念设计，不能伪装实物照片或测量图。

当前无实验曲线或性能图；只有实际数据通过质量与归因检查后才生成结果图。
