yolkytygyfse-a11y/pv-senselab/paper/manuscript/README.md

# 论文源

后续按实际投稿格式维护论文源，格式/模板 TBD。研究问题、实验设计与模型假设可以先论证，结果和摘要的数值必须有证据后填写。

每个实证结论关联实验/scan/analysis ID，披露样本结构、排除与失败、环境匹配、测量和参数不确定度、模型失配及泛化局限。当前不生成空结果段或虚构摘要。
