yolkytygyfse-a11y/pv-senselab/docs/SENSOR_SPEC.md

# 传感与计量规格

版本：0.4；日期：2026-10-25；状态：用户提供 SM7820B RS485 正确手册，已核对通信与寄存器；原 SM7820C 仅留来源追溯。PT100 类型已确认，实物配置、线制、标定与测量尚未验证。TBD 索引见 [HARDWARE_SPEC](HARDWARE_SPEC.md#全项目-tbd-登记册)。

## 测量边界与通道

统一在登记的 DUT 输出端测量 V/I；基线 DUT 为组件及固定连接夹具，注入损耗时 DUT 包含登记的等效损耗网络。端子取样、支路位置和接线照片写入元数据，不能混合组件端与夹具输出端参数。温度为组件背板接触测量，不直接等同电池结温。

| channel | 量/单位 | 接口与链路 | 原始记录 | 主要误差/质量要求 |
|---|---|---|---|---|
| pv_voltage | DUT 输出电压 V | 受保护分压 + ADC；器件/比值 TBD-06 | ADC code、通道配置、采样窗 | 分压比/温漂、基准、输入阻抗、开路加载、导线压降 |
| pv_current | DUT 向负载输出电流 A，发电输出为正 | Kelvin 分流+放大器/ADC；位置 TBD-06 | ADC code、增益/量程、采样窗 | 零偏、热电势、温漂、共模、负担电压与 V/I 时差 |
| module_temperature | 背板温度 °C | PT100 + MAX31865，SPI | RTD code、故障寄存器、Rref/线制配置 | 接触/空间梯度、引线、自热、标准电阻、热滞后 |
| ambient_temperature | 环境温度 °C | SM7820B，RS485 Modbus RTU；配置/实物待核对 TBD-08、10 | 原始请求/响应、寄存器/状态、配置 | 太阳直射、通风、响应、负温编码与安装高度 |
| relative_humidity | 相对湿度 %RH | SM7820B PDU0x0001，准确度/标定 TBD-08 | 原始请求/响应、寄存器/状态、配置 | 结露、恢复、污染、交叉温度影响 |
| irradiance | 组件平面辐照度 W/m² | RS485 Modbus RTU | 请求/响应帧、寄存器原值和转换配置 | 余弦/光谱/温度响应、安装倾角、遮挡、校准和响应时间 |
| surface_state | 表面状态，单位/型式 TBD-11 | 仅预留，不默认接相机或模拟口 | 接入后定义，当前 unavailable | 未装传感器不得输出“清洁度”伪值 |
| load_temperature | 负载保护温度 °C | 型号/位置 TBD-15 | 原值、状态和比较器事件 | 与结温的关联、断线故障安全；独立于组件 PT100 |

项目允许工作范围、分辨率/准确度目标、采样率、滤波带宽和最大陈旧时间仍须按 TBD-20 冻结；下文手册标称值不等于已经批准的系统工作范围。器件 ADC 位数或手册精度不是系统实测精度。负载保护测温不可用时禁止扫描。

## 已有原型采集物料

用户于 2026-10-25 补充拥有 ESP32-S3 开发板、RS485 转 TTL、INA226、温度探头及 MAX31865 模块；记录采购事实，不视为测量链通过验收。INA226 可作为 V/I 原型候选，最终主板前端仍待误差/时差/负担与保护预算。按 [TI 官方资料](https://www.ti.com/product/INA226)，芯片监测总线为 0–36V，电流由分流压降换算；第三方模块分流阻值/额定功率、端子电流、I²C 上拉及量程均需实物核对。50W 组件功率不能替代 Voc/Isc 和最坏包络。

当前已有 Arduino 台架驱动，入口见 firmware/pv-sensing/siri；器件上电关闭，按接线核对后逐路启用。未知分流/Rref/倍率产生原值和明确原因/null。SM7820B 映射已确认，换算须显式设置倍率，高位温度另确认标准补码；未知时保留 null。代码验证不代表实物通信、响应时间、参考资格或整链精度通过。

## PT100 / MAX31865

PT100 是确定的测温路线，具体探头等级、线制、工作温度、封装与粘贴工艺 TBD-08。MAX31865 使用 SPI 并支持不同 RTD 线制，须匹配实际接线和 Rref，读取故障状态。[ADI MAX31865 官方资料](https://www.analog.com/en/products/max31865.html) 是接线及转换依据，不把芯片手册指标当作背板测温系统精度。

采购术语已澄清：用户于 2026-10-25 确认已购探头是 PT100。它属于 RTD 热电阻，与 MAX31865 类型匹配，不再将其记为热电偶。实际 2/3/4 线、探头等级、Rref、模块电平/焊接配置和背板安装仍需核对；类型匹配不等于整链已标定。

保留原始 RTD 比值读数、Rref 名义/实测值与不确定度，转换使用有版本的 PT100 电阻—温度关系及系数来源。校准先以标准电阻验证读出链，再用温度参考验证整条探头/粘贴测量链；不能用电阻替代整条热学链验证。检查自热、导热胶厚度、接触稳定性和重复安装差异。

## RS485 辐照度

用户已购 RS485 辐照度传感器并提供《SM9569 产品使用手册》V23.10.14（9 页）。2026-10-25 已核对参数及接线/协议页；手册中 SM9569B 对应 RS485，M/V5 为其他输出版本，实物铭牌后缀尚待核对。误发论文按用户要求忽略。

| 项目 | 手册内容及页码 | 当前资格/限制 |
|---|---|---|
| 厂商/家族 | SONBEST/搜博，SM9569；p.1–2 | 实物后缀/序列号待核对 |
| 辐照度范围 | 0–2000W/m²；p.2 | 厂商规格，未实测 |
| 最大允许误差/重复性 | ±7% / ±5%；p.2 | 未明确百分比参照、覆盖条件/不确定度，不能当作已校准整机指标 |
| 波段 | 380–730nm；p.2 | 不据此宣称覆盖整个太阳光谱或已具 PV 参考资格 |
| 电源 | DC12–24V 1A；p.2 | 按手册要求核对实物电源，1A 的实际工作/峰值电流含义未说明；不可据此虚算耗电 |
| 接口 | RS485，Modbus RTU；p.5 | 仅对应 RS485 版本；模块 TTL 电平/线序仍未知 |
| 默认配置 | 地址 1；非记录仪表 9600、8N1；p.5–6 | 手册默认，非实物已读取配置；记录仪版本另列 115200 |
| 读取 | 功能码 0x03、PDU 地址 0x0000、数量 1；p.5 | 组态地址 40001，不将 40001 当成线上地址 |
| 换算倍率 | p.5 示例写“假设数据倍率为 100” | 没有明确确认本机辐照度倍率，保持 TBD-09，不能直接除以 100 或默认为 1 |
| 接线 | p.4 为电流/电压型示意；p.5 有外观 | 不能据类比为 RS485 版指定线色/物理针号，需厂家/实物接线定义 |

根据手册波段和误差描述，本项目暂将其作为待校核的环境观测通道，先通过参考对比、光谱/角度响应适用性及误差预算，才判断能否用于定量 PV 归一化与参数研究。这是本项目的资格限制，不是厂家已给出的分类或已测性能。不得把“进口数字式/较高精度”等宣传语当校准证据。

传感器与组件平面一致、避免清洁机构和人员投影，记录倾角/方位、安装距离与校准信息。局部遮挡实验的遮挡物作用于 DUT，不能无意遮住环境观测仪表。

寄存器地址起算方式、功能码、字节/字序、有符号性、缩放、异常码和串口参数按厂家文档确定；禁止假设常用地址或固定倍率。原始 Modbus 帧、CRC 校验与超时失败均保留，错误样本转换值为 null 并标志，无旧值冒充新测量。

现阶段可以设计只读原始寄存器归档；倍率未确认时工程量为 null 并标 SCALE_UNCONFIRMED，不将未经确认的 raw counts 输出为 W/m²。默认串口参数、示例帧和 CRC 的文档核对均不是通信实测。响应时间、实际配置、倍率、校准、模块电气与 RS485 线序仍待关闭。

## RS485 环境温湿度：SM7820B

用户确认《SM7820B 产品使用手册》V24.3.19（10 页）为正确手册，解决先前 CAN 资料与实物报告的接口冲突；原 SM7820C 不作为当前配置依据。

| 项目 | 已核对的手册依据 | 限制 |
|---|---|---|
| 接口/默认 | p.2、7：RS485 Modbus RTU、9600/8N1、地址 1；记录仪另列 115200 | 工业模块默认与当前共享 UART1 配置一致，实物是否改过尚未读取 |
| 供电 | p.2：DC5–24V 1A | 1A 不视为实测功耗；与 SM9569 共用 DC12V 仅为候选，须核对实物/预算/保护 |
| 接线 | p.4：红电源+、绿电源−、黄 A+、蓝 B− | 手册图示；无原厂引线时颜色仅供参考，实物端子仍核对；禁止工业电源接 MCU 信号脚 |
| 温度 | p.2：-30–85°C、±0.5°C @25°C | 厂商标称非系统实测精度 |
| 湿度 | p.8：PDU0x0001 为湿度寄存器 | 支持湿度已确认；本手册参数表未列湿度准确度/测量范围，不沿用 CAN 版指标；软件仅检查物理 0–100%RH |
| 读取 | p.7–8：FC03，PDU0x0000 温度、0x0001 湿度；数量 2 | 读请求 01 03 00 00 00 02 C4 0B；40001/40002 为组态地址，不是线上 PDU 地址 |
| 倍率 | p.8 正值说明仍用“假设倍率100”，负温例使用 /100 | 默认不冻结倍率；显式 env_scale 设置每 count 单位系数，厂家/参考核对后才用于工程量，未设则 null |
| 负温 | p.8 声称补码，却以 raw−65535 计算，并以 >32768 判负 | 标准16位补码应从0x8000起按 raw−65536；两者差一个 count。软件默认不解释高位温度；确认标准补码后 env_signed_temp=1，不照抄错误算式 |
| 示例完整性 | p.7 正文响应与表格数据不同，均列 DB EA | 必须离线重算并严格按原始字节校验，不修补设备 CRC 以迎合示例；坏帧不输出工程量 |

当前台架版本按已确认的 SM7820B 映射读取双寄存器，仍保留显式 raw 通用模式。工程解码仅允许已匹配 FC03/PDU0/数量2，温度和湿度分别报告状态，保留原码、倍率、负温配置；量程越界/帧错/配置未确认均为 null。读出事务窗不是设备真实转换窗。环境仪表防太阳直射并通风，PT100/MAX31865 独立测背板；响应/平均窗/无效码和整链校准仍待核对。

SM7820B 与 SM9569 手册默认均为地址1；合并总线前须逐只核实并以厂家工具/规程改成不同实物地址，常规采集不代写，用户授权/单仪表隔离后的受限改址例外见API_PROTOCOL。仅改主站查询地址不会改从站地址，即便 disable 一通道也不能让另一只同址实物停止应答。RS485 模块电平/方向/终端/参考地仍按 TBD-10 验证。

## 同步与滤波

V/I 每点记录各自采样窗及 `vi_skew_us`；优先选择满足预算的同时采样或可界定时差方案。把“依次快速读取”称为同步前，须证明扫描斜率与时差导致的误差在预算内。稳定等待时间、重复采样次数与滤波由动态验证确定，不在此虚构速度。

慢通道独立采样并记录开始/结束/设备时间；若仪表只给读取时间，记录其响应/平均窗来源。每点关联环境样本 ID 和 age，超出阈值标记 `STALE_CONTEXT`。数字滤波前数据必须保留，均值、窗长、剔除规则与版本写入处理配置。

## 标定规程和误差预算

1. 登记仪表、序列号、规格/证书、有效期与测试环境（TBD-19）。无溯源证据时必须披露，不能宣称已溯源。
2. V/I 在零点和覆盖目标工作区的多个点双向校准；点数/覆盖与参考配置由误差预算冻结。记录参考读数、原始码、加载方式、温度和重复记录。
3. 先验证通道无饱和、单调性、偏置、增益、非线性及热漂移，再选择最简足够的转换关系；保留残差与适用范围，禁止超范围无标志外推。
4. 温湿度/辐照度先核对厂家校准，再做同条件参考对比；厂商校准、实验室校准与现场核查需区分。
5. 动态验证负载阶跃、采样延迟和滤波建立时间，检查电机动作/USB 接入的噪声影响。

转换规则至少包含 `calibration_id`、设备/通道、公式版本、系数及单位、有效范围、有效时间、标准不确定度/协方差、参考记录路径与摘要。更换分流、ADC、Rref、探头或增益须重新判断标定有效性。

单通道预算分解为参考仪表、增益/偏置/非线性、量化、温漂、重复性、线缆、接触和同步分量；相关项不得简单独立求和。功率一阶传播为 `u(P)^2 ≈ I²u(V)^2 + V²u(I)^2 + 2VI·cov(V,I)`；非线性特征/拟合使用可追溯的重采样或蒙特卡洛传播，输入分布与假设须披露。报告标准/扩展不确定度时给出覆盖因子与方法，误差和不确定度不得混为一谈。

## 后续验收

每通道提交原始校准记录、残差、重复性、漂移与故障注入。合格阈值须事前冻结为 TBD-20 的正式值，当前未通过任何准确度验证。参考方案和数据结构分别见 [BOM](BOM.md) 与 [DATA_DICTIONARY](DATA_DICTIONARY.md)。

2026-10-25实物配置记录：SM7820B已在单仪表条件下从地址1改2，记录16严格读回2号地址寄存器0x66值2且CRC有效，17独立普通数据确认，18在ESP32重启后以固件0.4.6默认2只读确认。工厂默认1仍适用于新设备；已配置实物不得再当1号并接。传感器12V断电保存、倍率、测量精度和校准均未验证。辐照度1号及共线待复查，原始证据见tests/integration/README.md。

共线复查更新：用户报告恢复外置电源后，19在2号连续读回0x66=2；20同接线0.4.7、100ms事务空闲下1号辐照度与2号温湿度在约20秒各21帧CRC有效，末笔原码分别0与2589/6029。未知倍率继续输出工程量null，0原码不作为0W/m²结论。地址检查首笔超时保留；长期/重复断电、精度与校准仍待验证。

## PT100实物信息与三线异常诊断（2026-10-25）

用户确认PT100贴片型、商品标“2B级”，并提供MAX31865模块图；Rref位置标431，对应标称430Ω。标称值不是精密实测值，2B的标准/公差含义及探头曲线系数仍需厂家资料，不据商品称谓承诺整链误差。用户报告选择焊盘连3/断2、4，同端两线分别接F+/RTD+、负端短接、正端2Wire断开，探头在室温未加热；尚未提供导通实测。

21/22同接线模式对照：软件三线模式原码25217–25218，二线模式8390–8392；config分别145/129、fault均0。只有配置/原码通过，不代表温度合理。按标称430Ω，二线模式计算约110.10–110.12Ω，对应名义PT100曲线约25.94–26.01°C；这是未补偿、未校准的诊断换算，不能替代三线测温验证。不得除3或反推Rref使异常三线值贴近环境温度。

独立23使用官方Adafruit MAX31865 1.6.2、固定提交02dd3393d9750ca6e227be84b0e3b795a6941c36及BusIO1.17.4、软件SPI、同一CS10/MOSI11/MISO13/CLK12复现：三线25216–25220、二线8391–8393，故障0。支持将排查重点放到三线补偿支路/实际导通/板或芯片行为，不能凭这些数据断言具体焊点错误或模块损坏；也不能把自写驱动或硬件SPI当唯一原因。官方[驱动来源](https://github.com/adafruit/Adafruit_MAX31865/tree/02dd3393d9750ca6e227be84b0e3b795a6941c36)、[三线接法](https://learn.adafruit.com/adafruit-max31865-rtd-pt100-amplifier/rtd-wiring-config)与[MAX31865引脚/三线原理](https://www.analog.com/media/en/technical-documentation/data-sheets/MAX31865.pdf)已核对；仿制板具体走线仍需实测。

三线选择桥改动后24复测不通过：原码0–1，5笔中2笔fault=0x40（RTD低阈值故障），其余fault0也不能证明电阻/温度合理。与2/4默认接地桥未断、接通3后F+被拉地的假设相符；仅为假设，需断电导通或实物图确认。原始记录已保存、偏置已关闭；标称430Ω不能用于宣称当前温度值。

选择桥切断尝试后25仍不合格：三线原码11258–11269、fault0，按标称Rref约148Ω，与此前室温条件不符，不能把fault0当测温正确。26/27随后无主控串口回复，不属于新增有效温度数据；待恢复主控后继续核对实物补偿支路，暂不追加Rref温度换算。

主控恢复后29/30模式对照仍不通过：同接线三线11195–11216、二线控制8390–8394，均fault0，Rref未配置、温度null。按标称430Ω前者约147Ω与室温条件不符，后者约110.1Ω只作诊断参考；异常随补偿开启出现，具体物理通路需已焊切实物图/导通确认。停止继续割线和温度换算，配置恢复三线、所有通道关闭。

实物图检查补充：当前照片左2/3Wire加焊、右2Wire未见明显锡桥；选择区焊锡/反光遮挡，不能确认导通或隔离。上方叉形端头遮住端子进线口，需核对每根导体确实夹紧且无邻端接触；正面从左端子为F−、RTD−、RTD+、F+，同端两线应分接RTD+/F+，负端两孔短接接另一线。实际Rref字码在本图不清，430Ω仅此前商品图标称依据。原图与来源SHA256位于data/raw/bench/20261025-pt100-physical-inspection，无新增电气验证或测温合格结论。

用户随后报告断电测中间选择焊盘↔F+为0Ω，探头保持接入时F+↔RTD+为0Ω、RTD+↔RTD−为100Ω。上述为用户表读报告，精度/小数与单位屏显未留存；外部回路导通得到支持，但芯片FORCE2实际引脚通路与ADC比例异常尚未关闭。实物Rref字码不清，下一步核实完整RTD表读及Rref两端断电在板值，不再凭商品图默认430Ω或取整100Ω宣称转换合格。

用户补充RTD支路完整表读113Ω、Rref两端428Ω，为用户断电在板报告，未附仪表精度/校准且与此前ADC异时取得，不作精密校准或同步温差结论。此前100Ω报告被此补充更正。外部回路得到部分支持，仍无芯片FORCE2完整导通或已知标准电阻/正常模块对照；只能确认当前三线补偿异常，无法判定出厂缺陷或焊切影响，不追加盲目割线/补焊。

0.5.0临时参考测温方案：三根物理引线保持不动，显式关闭三线补偿位，以原始比值及用户报告的428Ω参考电阻换算名义PT100温度，标记LEAD_RESISTANCE_UNCOMPENSATED和UNCALIBRATED。该工作方式没有宣称满足数据手册的标准三线补偿或计量性能；导线/接触与非精密Rref误差保留。输入端电压及激励不增加，无新的功率动作；故障/饱和/无配置规则保留。后续以动态响应及参考源检验，三线补偿异常单独待修。

0.5.0实物参考模式31取得11笔参考温度24.54997–24.65096°C，原码8388–8391、电阻109.56006–109.59924Ω、fault0、配置129；保留物理线3及补偿关闭字段，LEAD_RESISTANCE_UNCOMPENSATED/UNCALIBRATED标志完整。独立按428Ω和名义PT100曲线换算逐笔一致，原始数据及错误/启动字节归档。此模式运行通过不关闭三线补偿异常，也不替代Rref精密校准、引线/接触误差及同步参考温度验证。
