yolkytygyfse-a11y/pv-senselab/docs/design/pv-dashboard-concept.png

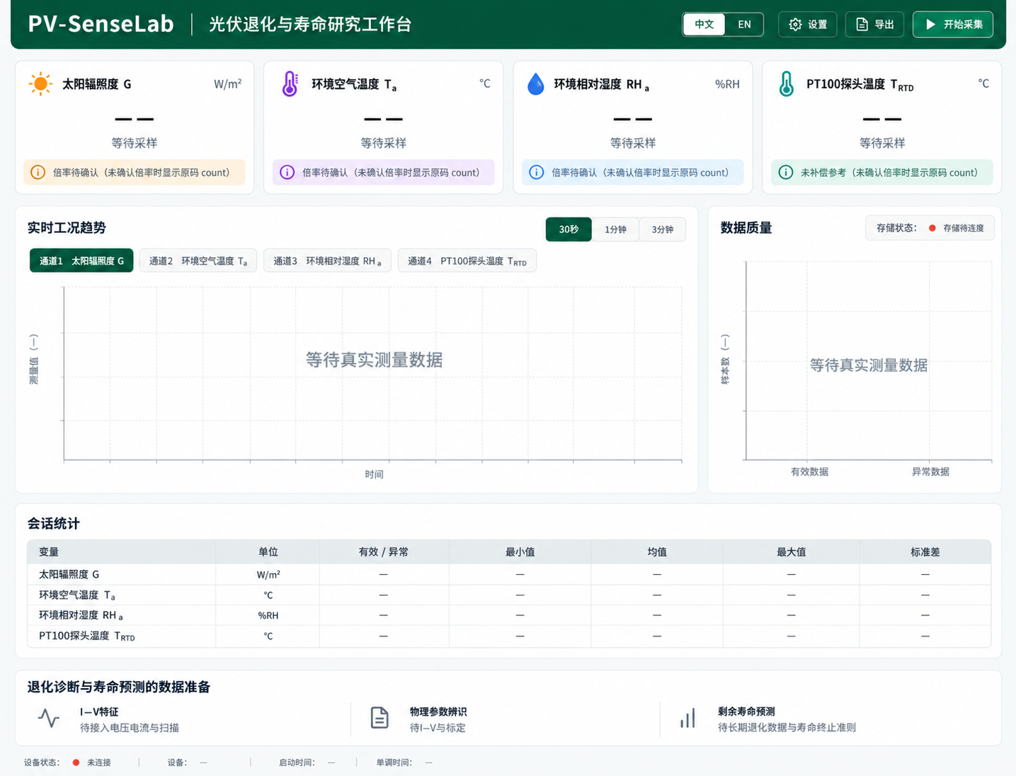
docs/design/pv-dashboard-concept.png
