yolkytygyfse-a11y/pv-senselab/docs/design/pv-dashboard-en.png

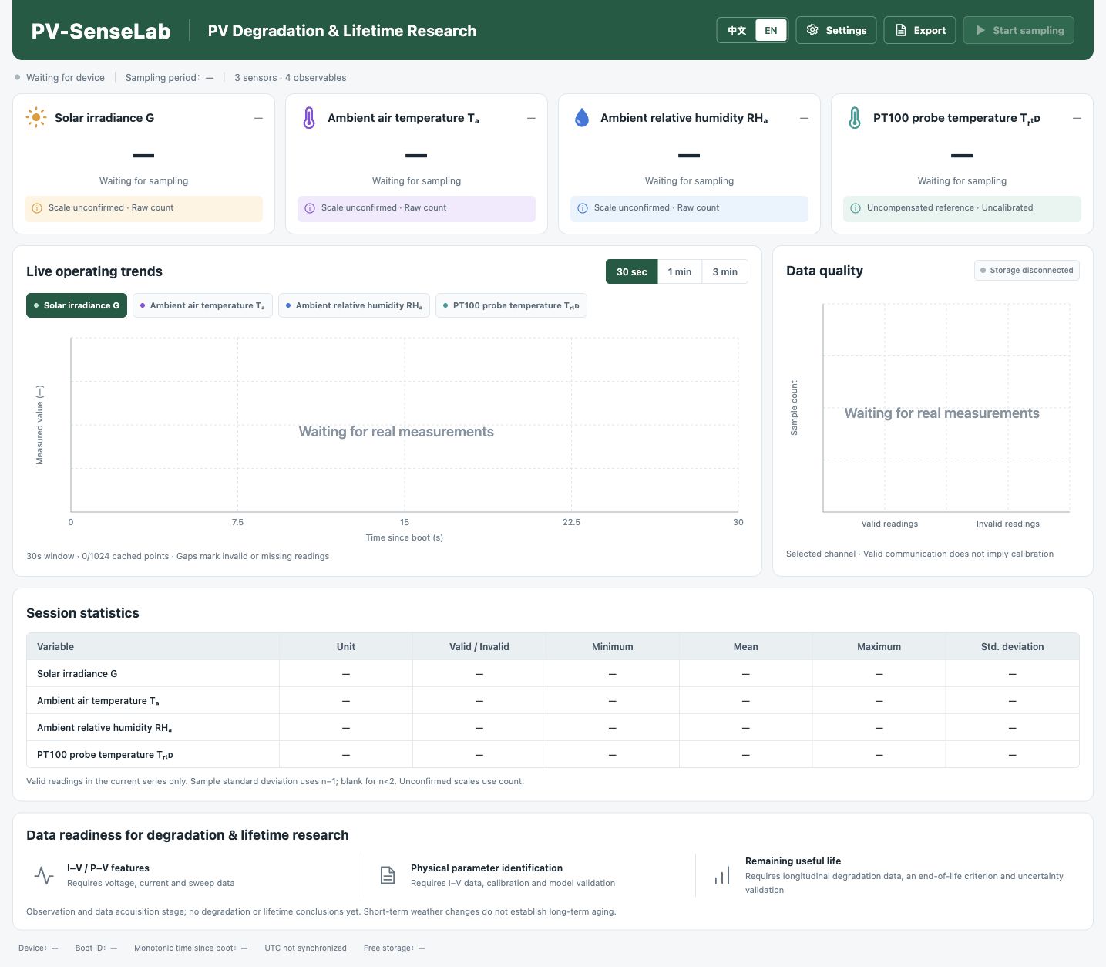
docs/design/pv-dashboard-en.png
