yolkytygyfse-a11y/pv-senselab/docs/design/pv-dashboard-mobile-en.png

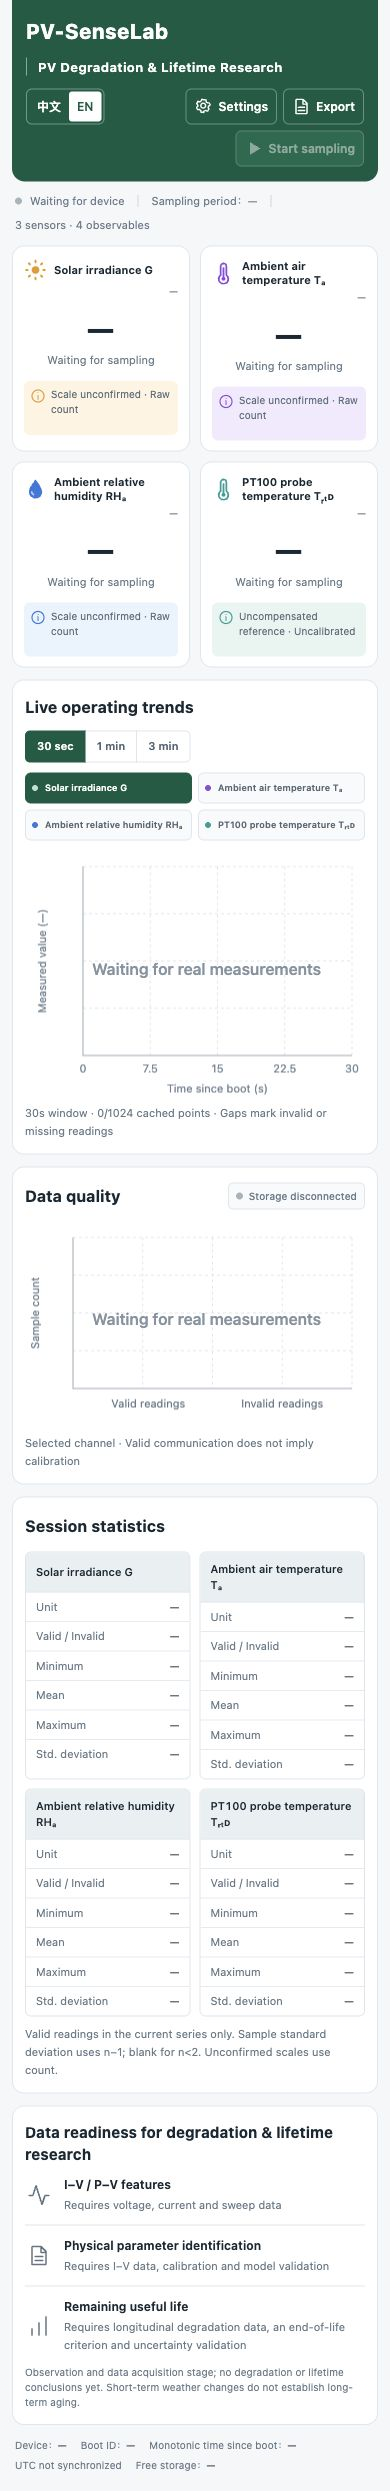
docs/design/pv-dashboard-mobile-en.png
