yolkytygyfse-a11y/pv-senselab/docs/design/pv-dashboard-zh.png

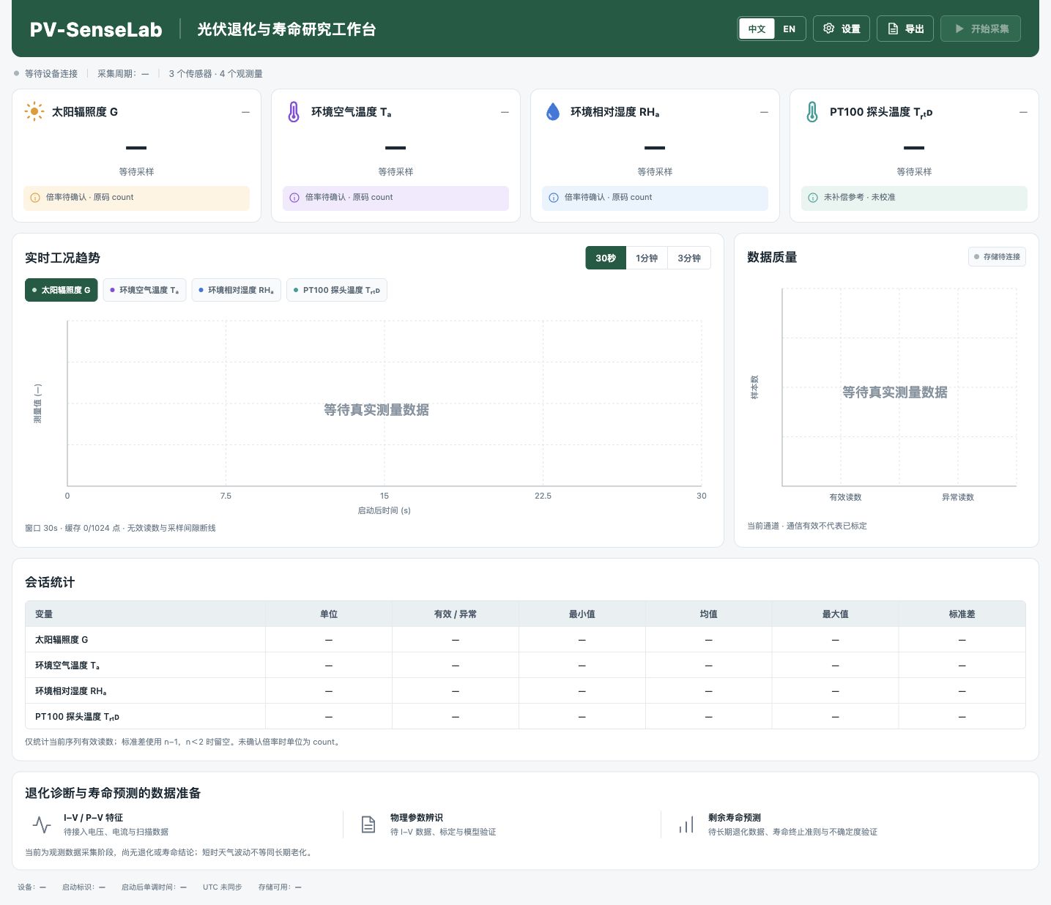
docs/design/pv-dashboard-zh.png
