yolkytygyfse-a11y/pv-senselab/firmware/components/README.md

# 固件组件职责

仅在实现需要时创建模块：测量链（ADC/INA226 原型、PT100/MAX31865、RS485 环境温度与 SM9569 辐照度）、负载控制与安全、协议/时钟、清洁控制。驱动返回原值、状态和时间，不把失败转换为零测量。两个兼容 RS485 仪表共用 UART1，单请求轮询；环境协议/寄存器/编码按正确手册确认，不套用 CAN 版本。

优先使用 ESP-IDF 现有能力与器件官方接口，不提前建通用插件框架。对每个驱动固定手册/配置版本并保留真实台架验证记录；单位转换和数据校验与数据字典一致。当前只有职责说明，无可链接组件。
