yolkytygyfse-a11y/pv-senselab/docs/BOM.md

# 功能 BOM 与选型约束

版本：0.6；日期：2026-10-25；状态：功能级清单，非最终采购单。已有SM9569家族RS485辐照度、SM7820B RS485温湿度、50W组件、ESP32-S3、RS485转TTL、INA226、PT100/MAX31865。SM7820B正确手册已核对，无需CAN；实物配置/电流/电平/倍率/标定与50W量程/SOA/热/保护仍待审查；具体采购料号/数量/价格未冻结。

## 已有物料与原型采购顺序

整机原理图由本项目自行设计，最终交付为主采集板、独立电子负载板和清洁接口/驱动设计。原型转接板用于核对传感器、驱动和量测链，不替代自研电路、保护设计或校准。

| 顺序 | 采购/准备项 | 原型建议数量 | 下单或使用前条件 |
|---|---|---|---|
| 已报告购买，已核对家族手册 | RS485 太阳辐照度传感器；SM9569B 对应手册 RS485 型 | 实际数量待登记 | 手册列 DC12–24V 1A、Modbus RTU；核对实物后缀、实际地址/速率、倍率、校准和线序；TBD-09 未关闭 |
| 已报告购买，范围变更待确认 | 50W 光伏板 | 实际数量待登记 | 超出原 10–20W 边界；先确认是否改用此板并提供型号/Voc/Isc/温度系数，重新设计量程、SOA、热与保护后才能接入，不重复建议购买组件 |
| 已报告拥有 | ESP32-S3 开发板 | 数量/数据线待核对 | 确认实物板型、模组变体、GPIO/电源原理图，不重复建议采购；不代表最终主板采用开发板插接 |
| 已报告购买，类型已澄清 | PT100 + MAX31865 转接板 | 实际数量待登记 | 类型匹配，核对 2/3/4 线、Rref、探头安装与电平；TBD-08 未关闭，不重复建议采购 |
| 用户确认正确手册，实物配置待验 | SM7820B RS485 温湿度仪表 | 实际数量待登记 | V24.3.19：DC5–24V、9600/8N1、默认地址1，FC03/PDU0及1；核对实际电源/配置、倍率/负温/校准，不重复采购 |
| RS485 转 TTL 已有；USB 适配器可选 | RS485 转 TTL 模块；可选 USB-RS485 调试适配器 | 模块实际数量待登记，USB 适配器可借用 | 核对 TTL 侧电平、RO 输出、供电、自动/手动方向、隔离/参考地、终端偏置；有模块不等于可直接接 ESP32，不重复建议购买 |
| 可借用优先 | 可调限流电源、参考万用表、示波器 | 根据实验室已有设备补齐 | 电源范围取决于组件/传感器/驱动；仪表规格与证书用于 TBD-19/20，不预先承诺溯源 |
| INA226 原型模块已购；最终前端待设计 | V/I 前端、ADC/基准 | 模块实际数量及正式通道待确认 | INA226 为 0–36V 总线监测芯片，模块分流值/功率/走线和温升未知；先核对 Voc/Isc、校准、转换时差与上拉电平，再判断是否满足扫描，未冻结为最终科研方案 |
| 设计后第二批 | DAC、运放、MOSFET、控制分流、比较/锁存/心跳、断开与散热器件 | 按独立负载原理图确定 | 线性 SOA、持续故障热预算、端点和保护审查；不以通用成品负载替代自研板 |
| 机构确定后 | 清洁电机/泵/传动、驱动、限位、线束和急停 | 按机构确定 | 干湿工艺、行程/堵转、电源、续流和互锁；不先买大电流驱动板再反推需求 |

目前可先核对/准备通用调试物料与测温/温湿度链。辐照度接口、电源、V/I 前端和负载功率器件的具体购买清单，必须等待组件及已购传感器信息。上述数量是原型准备建议，不是统计样本量或已购事实。

| 功能单元 | 路线/关键器件 | 数量口径 | 选型关键项 | TBD |
|---|---|---|---|---|
| 待测组件 | 已购 50W 板，型号 TBD；原 10–20W 需求是否变更待确认 | 单台架被测单元，数量/研究样本数待核实 | 独立低压属性、Voc/Isc/系数、串联数、旁路、端子；变更后重新审查功率与保护 | 01、02、03、21 |
| 主控 | ESP32-S3；模组型号 TBD | 主采集板一套 | IO/USB/启动脚、供电、存储与温度范围 | 04、05 |
| 电压前端 | 分压、保护、RC；值/料号 TBD | 按测量通道 | 最大输入、加载、精度/温漂、钳位漏电 | 02、06 |
| 计量电流前端 | Kelvin 分流、放大器；料号 TBD | 按计量通道 | 负担电压、共模、温漂、量程和功耗 | 02、06 |
| 科研 ADC / 基准 | 外置方案优先候选，型号 TBD | 通道与同步方案决定 | 同时/顺序采样时差、输入范围、噪声、速率、漂移 | 06、20 |
| 组件温度 | 已确认 PT100 + MAX31865；型号/封装与线制仍待核对 | 单组件测温链，空间核查点数 TBD | 探头等级、粘贴、Rref、故障诊断与整链校准 | 08 |
| 环境温湿度 | SM7820B，RS485 Modbus | 环境观测链 | 共线不同地址、参考地/终端、防辐射安装、响应、倍率/负温与校准 | 08、10、20 |
| 辐照度仪 | SM9569 家族手册已核对，SM9569B 为 RS485 Modbus RTU 型；实物后缀待核对 | 组件平面观测链；参考资格待评估 | 手册标 0–2000W/m²、最大允许误差 ±7%、重复性 ±5%、波段 380–730nm；倍率/实际配置/参考资格仍待核对 | 09、19、20 |
| RS485 接口 | 已有 RS485 转 TTL 模块；最终收发器、终端/偏置/保护料号 TBD | 总线配置决定 | 模块型号、TTL 电平/方向控制、共模、ESD、隔离和地参考 | 09、10 |
| 表面状态预留 | 受保护连接器/供电/数据，型式 TBD | 接口位，当前无传感器 | 用途、电压、带宽、防误插 | 11 |
| 负载设定链 | 数字 DAC、基准，型号 TBD | 电子负载板一套 | 上电值、精度、输出范围、接口/速率 | 10、13 |
| 负载模拟环 | 运放、控制分流、补偿网络 TBD | 环路设计决定 | 输入共模、输出摆幅、稳定性、热漂移 | 13 |
| 吸收器件 | 有合适线性 SOA 的 MOSFET；型号/数量 TBD | SOA/热设计决定 | Vds/Id/持续时间/壳温、直流失控工况 | 03、13、15 |
| 负载保护 | 电流/温度比较、锁存、独立关断、急停 TBD | 危害分析决定 | MCU 卡死/器件短路时的独立性 | 10、15、16 |
| 开路/近短路路径 | 开断元件/端点方案 TBD | 不预设具备硬短接 | 漏电、负担、电压余量、失效安全 | 14 |
| 散热 | 散热器/导热介质/风扇/测温 TBD | 热预算决定 | 结温路径、风扇故障、机械防护 | 15、17 |
| 清洁机构 | 电机/泵/刷具或其他工艺 TBD | 独立模块一套，具体物料 TBD | 干湿、行程、压强、堵转和寿命 | 12 |
| 清洁驱动/反馈 | 驱动器、续流、限位、电流/温度保护 TBD | 机构决定 | 启动/堵转、电磁干扰、急停、互锁 | 12、16 |
| 辅助电源 | 隔离限流实验电源及稳压支路 TBD | 电源树决定 | 输出电压、预算、纹波、USB 回灌 | 04、12 |
| 输入保护/连接器 | 反接、熔断/限流、TVS、隔离开关 TBD | 两板+线束决定 | 故障电流可断性、温升、电压及防误插 | 02、10、16、17 |
| 等效损耗夹具 | 串/并联精密功率电阻、可断支路 TBD | 因素水平决定 | 阻值实测、温漂、功耗、测量平面 | 02、21 |
| 标定与参考 | DMM/参考源、标准电阻、温度/辐照参考 TBD | 按规程配置 | 规格/证书、范围、接线及不确定度 | 19、20 |
| PCB 与机械 | 立创EDA工程、板材、外壳、支架、线束 TBD | 两块独立电路板；清洁接口实现 TBD | 工艺、尺寸、铜厚、接地和散热 | 17、18 |

## BOM 冻结流程

需求包络 → 候选手册/符号/封装核对 → 量程/误差/SOA/热/保护审查 → 确认渠道与替代性 → 审批料号/封装/数量/版本。每个替代器件重新判断电气、PCB、固件和校准影响，不能只看脚位或名称相似。

ESP32-S3 和 MAX31865 是用户确定的器件路线，不表示其具体模组或封装已经选定。不得自行填写 INA/ADS/运放/MOSFET 等型号以制造选型已完成的印象。

## 资料入口（访问核对日：2026-10-20）

- [Espressif ESP32-S3 资源](https://www.espressif.com/en/products/socs/esp32-s3)：最终模组的实际电气参数须再核对对应版本手册。
- [ESP-IDF ESP32-S3 ADC 文档](https://docs.espressif.com/projects/esp-idf/en/stable/esp32s3/api-reference/peripherals/adc/index.html)：片内 ADC 有校准驱动，但系统测量仍须整链验证。
- [ADI MAX31865 产品与手册](https://www.analog.com/en/products/max31865.html)：RTD 链路选型与线制核对入口。
- [ESP32-S3-DevKitC-1 官方开发板资料](https://documentation.espressif.com/api/resource/path/docs/projects/esp-dev-kits/en/latest/esp32s3/esp32-s3-devkitc-1/user_guide_v1.1.html)：原型开发板候选，最终变体与引脚仍需核对。
- [Sensirion SHT4x 官方资料](https://d.sensirion.com/product-support/sht4x-humidity-and-temperature-sensor)：数字温湿度原型候选，第三方转接板供电/上拉必须另外核对。
- [TI INA226 官方资料](https://www.ti.com/product/INA226)：已购原型模块的芯片功能依据，不代表第三方模块具有同等量程/精度；实物分流和标定另核对。

2026-10-25 已核对 SM9569.pdf（V23.10.14）；SM7820C (1).pdf（V26.5.28）为读过的 CAN 版本资料，用户后续明确实物 RS485，故仅保留来源追溯，不作为当前电气/协议/采购依据。正确环境手册 SM7820B V24.3.19 已补充并核对，来源摘要见 data/metadata/README.md。误发论文按用户要求忽略。

网页 stable 或器件资料可能更新；原理图冻结时需记录实际手册版本/日期和文件摘要。此阶段不下载器件库、不生成采购报价或 EDA 假文件。
