yolkytygyfse-a11y/pv-senselab/data/calibration/README.md

# 标定记录

未来保存 calibration_id 对应的版本化公式/系数/协方差、有效范围/日期、设备通道、参考仪表和证书索引、原始标定数据/摘要、残差与审批记录。文件不可用未测的“默认系数”填充。

小型非敏感标定记录审查后可入 Git；大附件独立归档但索引与摘要须保留。更换硬件或探头后重新判断有效性。当前无有效标定；方法见 [传感器规格](../../docs/SENSOR_SPEC.md)。
