yolkytygyfse-a11y/pv-senselab/experiments/README.md

# 实验工程

当前只有 [总实验计划](../docs/EXPERIMENT_PLAN.md)，尚无实验执行记录。

- [protocols](protocols/README.md)：在相关 TBD 关闭后冻结的实验规程。
- [runs](runs/README.md)：真实执行日志与偏离/故障记录，默认独立归档。

流程为保护通过→标定/备份就绪→预实验→冻结水平/重复数/排除规则→正式实验→独立分析。标签来自实际施加条件，失败扫描和无恢复结果也记录。仅独立 10–20W 低压组件，禁止接入屋顶系统。
