yolkytygyfse-a11y/pv-senselab/experiments/protocols/README.md

# 实验规程

后续每份实际规程须有 protocol_id/版本、问题、DUT/夹具、因素与水平、对照/随机化/重复、器材与标定、接线与安全检查、动作/扫描步骤、环境稳定窗口、异常停止、数据路径和事前分析/排除规则。

污染、温度、遮挡、等效电阻和清洁配对实验均需明确混杂因素。数量/阈值不能填拍脑袋默认值；由 TBD-21 预实验依据冻结。当前无已批准的可执行实验操作规程。
