yolkytygyfse-a11y/pv-senselab/experiments/runs/README.md

# 实际运行记录

未来按 experiment_id/run_id 保存操作者、开始/结束、实际因素、规程偏离、照片/接线引用、失败与处置、数据摘要和清洁动作关联。每次复测是新的 scan_id，不覆盖前测。

本目录除本说明外默认 Git 忽略，以免误提交大量附件；实际运行记录必须连同原始数据在已批准归档中备份并校验。当前没有运行记录。忽略不代表可删除或已经备份，位置/容量/保留和恢复要求 TBD-24。
