yolkytygyfse-a11y/pv-senselab/tests/integration/README.md

# 集成验证范围

后续用真实设备验证 hello/configure/arm/scan/stop、原字节与 JSONL/manifest 落盘、断联/复位/重复请求/磁盘满/缓存满、计数摘要、标定版本和重放一致性；记录实际命令与结束原因。

清洁闭环须有真实 pre_scan、授权 action、实际反馈及独立 post_scan，并覆盖环境不匹配/动作失败。测试不能自动复跑有物理副作用的动作。当前无可运行集成测试。

2026-10-25 首次实际串口诊断：115200/8N1下status收到合法JSON，当前固件0.3.0。三线RTD一次冷启动首笔configuration_readback_failed，随后4笔rtd_code=25240–25241、fault_register=0，Rref未知故温度null。原始收发和摘要在data/raw/bench/serial-diagnosis-20261025-02-status及03-rtd；这些是诊断记录，不是标定或正式实验。针对CS初始化顺序修正，验收需重新启动固件后检查首笔及后续配置读回，不能仅复用已初始化过的GPIO状态。

0.3.1实物验证：构建与上传校验通过后重启，04-rtd-cs-fix收录首笔与随后4笔，均config145/fault0、rref_unconfigured，原码25225–25228、temperature_c=null。7998字节/13合法JSON/1启动非JSON全部保留、摘要匹配；完成后stop并关闭通道。证据支持本次首笔初始化修复，不能证明整链温度精度或未知参考电阻正确。

外置电源恢复后05-rtd-power-restored复核5笔：config145/fault0、原码25223–25225、Rref未知温度null；7776字节/14合法JSON/0坏行，摘要匹配，采集结束已stop。两个RS485仍同址1，未发送查询或改址，INA226未接且禁用。

0.4.0改址实际尝试：用户确认仅接温湿度后，06日志预检1号地址寄存器读取无回复，按门禁没有进入write_once；07普通数据寄存器对1/2各两次查询均无字节返回。两目录原始收发/manifest摘要已重算匹配；当前未改址，等待TTL/物理链路核对，不因软件目标地址为2宣称设备已改成功。

0.4.1–0.4.4实物诊断：用户商品页明确TX-TX/RX-RX，保留实线并修正TX18/RX17后08首次读通两帧。09/10的0x66实际地址/FA读取预检无返回，均无写；不能由此证明寄存器不支持。12普通数据在同一固件首笔超时、第二笔成功。0.4.4加有界只读重试后，13前检第二次成功，只发一次改址写帧但无确认且2号无数据；14只读确认1号仍返回有效数据、2号两次无返回。改址未成功，不重复写。

13-env-bounded-commission: 4876字节/8合法JSON/1坏行，三个文件SHA256匹配；14-post-write-readonly: 9788字节/19合法JSON/0坏行，三个文件SHA256匹配。这些是原始诊断，不是标定/正式实验；通信方向证据不关闭模块3.3V商品声明与照片MAX485厂家供电范围冲突，未验收测量精度或保护。

12V确认后15只读对照：0x66首笔timeout后3次frame_ok且值1；普通100ms周期47次frame_ok、1次启动timeout、1次结束cancelled，57849字节/75合法JSON/0坏行，摘要匹配。支持寄存器存在，推翻此前基于首笔超时的“不支持”假设。0.4.5保留100ms维护空闲后16成功：旧址值1、只写一次、新址2返回0x66值2，3919字节/6合法JSON/1启动坏行，摘要匹配；写应答同请求不作成功依据。17独立读：1号两次timeout、2号第二次普通数据frame_ok（2630/5908），9788字节/19合法JSON/0坏行，摘要匹配。0.4.6仅同步主站默认2；主控重启后复查待执行，传感器断电保存与工程量/精度未验证。

0.4.6最终交付：构建Flash356142/RAM40664，上传校验通过；18主控重启后未设置查询地址、默认2返回CRC有效普通数据，结束停止且全禁用；5596字节/8合法JSON/1启动坏行，三个文件SHA256匹配，交付五文件与主源相同。仅ESP32重启，不是传感器12V断电保持测试。

共线19/20对照：用户报告接回A/B并恢复外置电源。19恢复后2号0x66四次CRC有效、值2；10ms事务空闲下1号11次有效、2号6次有效/5次timeout，32455字节/51合法JSON/0坏行，摘要匹配。0.4.7仅统一空闲100ms，同接线20约20.184秒数据轮询中1/2号各21/21有效，无数据轮询超时/CRC错误，最小实测事务间隔100.877ms；2号地址检查首笔timeout、随后3次值2。50204字节/70合法JSON/1启动非JSON，三个文件SHA256匹配，独立CRC/原码解析通过。无设备写入，结束停止/全禁用；源/交付五文件一致。此为短时台架通信验证，倍率/计量/保护、长期或重复断电保持未验收。

PT100当前诊断：用户确认PT100贴片2B（商品标注）、MAX31865，模块图431=标称430Ω；实际精度/导通未测。21三线5笔25217–25218、fault0、config145，22二线模式控制5笔8390–8392、fault0、config129，数据均保留且温度null；两线控制不等于三线测温合格。计划用固定官方库+独立软件SPI复核，自写驱动、SPI实现及三线支路分别作为待排查因素，完成后恢复生产固件。

PT100独立对照23：官方Adafruit MAX31865 1.6.2 commit 02dd3393d9750ca6e227be84b0e3b795a6941c36，现有BusIO1.17.4，软件SPI同引脚，三线原码25216–25220、二线8391–8393、fault0，复现3线模式偏差。5488字节/10合法JSON/1坏行、摘要匹配；首笔三线与启动非JSON前缀同一行，raw完整保留，派生恢复文件记录源摘要和偏移，不伪造收时。三线共5笔（4笔常规解析+1笔派生恢复）、二线5笔；完成事件确认偏置关闭。参考源/清单、临时sketch、编译上传日志位于firmware/pv-sensing/build/reference-*，官方源码固定提交并留SHA256清单，未安装全局库；测试后恢复原0.4.7二进制（SHA256 fb6524869b96118033bbcb6515920e0a784ed1f3d9bda7a04edada0aee83b3bc）并校验上传。三线温度仍未验收，待实物通路/参考检查。

24：用户报告短接中间与3后同一0.4.7三线复测5笔，code1/1/0/0/1、fault0/0/64/64/0、config145，Rref仍未配置、温度null。8460字节/16合法JSON/0坏行，三个文件摘要匹配；结束停止、偏置关闭、全部禁用。跳线改动前后原码由约25217到0–1，为物理补偿/接地通路变化提供证据，不判定具体故障点；已要求先断USB/12V核查2/4到中间默认桥是否真正断开。三线测温不通过，待修正后再测，不追加无依据温度换算。

25用户报告切断2/4默认选择桥后，三线原码11258–11269、fault0/config145，按标称430Ω约148Ω，室温合理性仍未通过；末状态停止/全部禁用。26后续二线对照及27仅status均0RX，只有主机TX命令记录，不能生成测量值或认定复测成功。官方esptool MAC读取/硬复位也No serial data received（退出2），未写Flash；电脑仍列出USB串口、未发现其他读取者，具体物理/主控通信原因未知，已要求用户重新插USB/按EN。25-pt100-after-default-bridge-cut：8508字节/16合法JSON/0坏行，三个文件摘要匹配；26-pt100-two-wire-after-bridge-cut：0字节/0合法JSON/0坏行，三个文件摘要匹配；27-status-after-empty-control：0字节/0合法JSON/0坏行，三个文件摘要匹配。主控恢复前停止继续硬件测量。

用户重插USB并复位后28恢复0.4.7状态通信；29三线5笔11195–11216（config145/fault0），30同接线二线控制5笔8390–8394（config129/fault0），温度仍null，按标称430Ω的约147Ω/110.1Ω只作诊断计算。28-status-after-user-reset：1605字节/1合法JSON/1坏行，三个文件摘要匹配；29-pt100-three-wire-after-user-reset：8510字节/16合法JSON/0坏行，三个文件摘要匹配；30-pt100-two-wire-after-user-reset：8913字节/17合法JSON/0坏行，三个文件摘要匹配。30末状态确认停止/全禁用，软件三线设置恢复。支持异常随三线补偿开启出现的判断，不能据此确定具体焊点或板/芯片故障；待已焊切实物近照/实际导通后再测，暂不追加割线或温度输出。

0.5.0参考模式实测31：11笔，rtd_code8388–8391，参考温度24.54997–24.65096°C；14654字节/23合法JSON/1启动非JSON。所有有效帧rtd_wires=3、rtd_compensation_enabled=false、rref_ohm=428、config129/fault0；status=reference_uncompensated，质量含LEAD_RESISTANCE_UNCOMPENSATED/UNCALIBRATED。以原码和428Ω独立计算R=code*428/32768及名义PT100曲线，逐条与固件输出相符；raw/commands/JSONL三文件SHA256匹配；主源与Arduino交付5文件相同，结束停止且全禁用。固件原生构建/上传校验通过、C++及Python2项测试通过。此为当前未补偿参考模式可运行证据，三线补偿故障与精度未通过，非实验性能结论。
