yolkytygyfse-a11y/pv-senselab/docs/design/VERIFICATION.md

# 双语科研展板验证记录

2026-10-25，0.6.0。GOAL：ESP32本地四通道科研展板与中英文切换；CONTEXT：三传感器/四观测量，研究目标为光伏退化诊断与寿命预测；CONSTRAINTS：无虚构数据/预测、未知倍率原码、未校准参考温度；DONE WHEN：构建上传、真实API、双语逻辑及可见页面分别有证据。用户最终确认仅设备热点，不加入路由器网络。

## 代码与设备

- 原生Arduino-ESP32 3.3.11，零额外Arduino库；HTML67438字节，gzip20560字节，设备GET /解压与源码逐字节一致。
- 构建Flash1038285/1310720字节、静态RAM106064/327680字节；用户Arduino目录5旧文件已备份、8文件同步一致。upload --verify退出0并确认写入Hash。
- C++统计/缓存测试、原协议/数学测试、Python2归档测试、Node双语/缓存/CSV逻辑测试通过；前端字典键一致，切语言不触发控制/清历史，CSV英中列名及故障空值已验证。
- 实机证据：data/raw/bench/serial-diagnosis-20261025-32-web-dashboard/verification.json；独立重算四通道样本统计匹配，manifest全部SHA256匹配。boot_id=23ecebb9ce62ff5f，四路各18有效、0异常（仅约18秒短测，不外推可靠性）。PT100未补偿参考24.48264–24.51631°C；前三项仍count，非校准工程量。API空方法/令牌/非法配置被拒绝，停止后合法配置与启动成功，运行中配置被拒绝；分页与原始下载62记录50734字节可解析。测试结束停止采集，电脑原Wi-Fi恢复。

## 可见界面与概念对照

采用内置浏览器IAB，无Playwright浏览器替代、无假API、无模拟测量。实机浏览器访问192.168.4.1的自动权限审查超时（不是安全性否决），一次重试仍未取得可用实机页面；因此下列截图是本机同版HTML的**未连接空态**，不冒充实机曲线。设备HTTP读取已独立验证。

概念：pv-dashboard-concept.png（1435×1096）；本地完整页面：pv-dashboard-zh.png、pv-dashboard-en.png；手机：pv-dashboard-mobile-en.png（视口390×844）。IAB实际点击中英、时间/通道控件和设置面板，检查全页文案，英文设置状态仅保留“中文”语言按钮中文字符。手机documentElement.scrollWidth=390、innerWidth=390，未发现横向溢出。截屏后使用view_image同时检查概念与最新英文完整页面。

| 比较点 | 概念与实现证据/处理 |
|---|---|
| 信息结构 | 保留墨绿顶栏、四通道、70/30趋势/质量、统计表、研究准备条；没有引入侧栏/营销区 |
| 科学文案 | 保留G/T_a/RH_a/T_RTD；修正概念中未确认时名义单位与不准确PT100提示，实际状态未知显示—/count；寿命条件补充不确定度，不编造数字 |
| 配色/控件 | 白/冷浅灰底、墨绿主色、琥珀/紫/蓝/青绿通道；圆角/细边框、同系列SVG仪器图标，双语分段切换 |
| 字体/密度 | 系统中英字体，标题/表格/轴名明确层级；英文较长允许换行，未裁切主控件 |
| 图表/表格 | 原生Canvas空格网、无虚构曲线；变量独立单位；样本标准差n−1、无效值断线，统计表字段保持一致 |
| 响应式 | 桌面原概念视口核对；手机两列指标、图表顺排、统计转为可读行布局，无横向溢出 |
| 留白/额外说明 | 有意增加采集状态行、缓存/标定/研究条件说明，因此完整页面高于1096，须向下滚动；避免隐藏数据边界 |

以上首屏文案对照无无关导航或性能承诺；新增状态/质量说明属于科学严谨性要求。视觉结构已按概念核对，未知单位/科研说明与完整页高度是有意调整。尚无实机浏览器曲线截图或整套网页控制/下载点击的端到端证据，不宣称已完成该项。

## 剩余验证

真实倍率、标定、安装条件、PT100三线补偿故障、长时运行、满盘/写故障、断电/非空未知分区保护与独立备份恢复未验收。没有新增或批准任何PV功率回路、SOA/散热/接地/保护设计；现有硬件TBD保持。当前寿命研究仍缺电气/I–V与长期数据，未实现退化/RUL算法。

## 2026-10-28：用户提供的运行截图

用户明确授权将其提供的运行页面截图公开至仓库README。文件docs/design/pv-dashboard-bench.png与用户附件逐字节一致，SHA256=ac9e939daca6a0bb0b06c506b3fd62a036ce08d9c202b93ed5db7e33188a8b0b；未修改数值、标签或曲线。画面显示原码0/2606/5921、PT100参考24.48°C及选中通道20个有效读数。此图来自用户运行会话，不是上文18笔/通道短测的截图，也不是通过自动浏览器获取的证据；未据此关闭自动化端到端交互验证。原码倍率未确认及未补偿/未校准限制均在英文README图注披露。本次没有发布原始测量文件或重新测试硬件。
