yolkytygyfse-a11y/pv-senselab/todo.md

# PV-SenseLab 工作清单

状态日期：2026-10-25。`[x]` 仅表示该条具体交付完成；技术能力、实测性能和评审结论另行验收。

## 第一阶段：初始化与规格

- [x] 检查目录为空，保护现有文件，初始化 `main` Git 仓库。
- [x] 建立 `.gitignore`、根目录 README、AGENTS 和本清单。
- [x] 创建十份 `docs/` 规格，覆盖 PRD、架构、硬件、传感、扫描、数据、协议、实验、BOM 与七周路线。
- [x] 建立两块电路板的模块规格、逻辑接口和清洁模块边界；明确原理图与 PCB 未完成。
- [x] 建立固件、软件、模型、实验、数据、论文、测试目录与职责 README。
- [x] 集中登记 TBD，建立需求与验收映射。
- [x] 完成结构、相对链接、Git 忽略规则和内容一致性检查：2026-10-20，51 个项目文件（50 个 Markdown），85 个本地链接/锚点无错误，26 个 TBD 引用已登记，R01–R11 与 7 周条目齐全；实测占位文件和产品代码为零。最终复查见下方记录。
- [ ] 由项目负责人评审规格草案，关闭启动原理图所需的 TBD；尚未开展。

## 下一步电路原理图任务

- [ ] SCH-01：确认组件型号、实物铭牌和厂家手册，记录 Voc/Isc、温度系数、串联电池数/旁路结构（TBD-01）。
- [ ] SCH-02：确定最坏电压/电流、工作温度、动态余量及吸收功率包络；签核量程与停机阈值（TBD-02、03、16）。
- [ ] SCH-03：确定主板/负载/传感器/清洁供电来源、电源树、USB 防回灌和接地/隔离方案（TBD-04、10、12）。
- [ ] SCH-04：完成两板连接器、逻辑电平、GPIO 复用/启动脚检查，固定 pinout 与线缆（TBD-05、07、10）。
- [ ] SCH-05：主板设计 PV 端电压分压、Kelvin 电流采样、ADC/基准/滤波；计算加载误差与同步误差（TBD-06）。
- [ ] SCH-06：完成 PT100/MAX31865、温湿度、RS485 辐照度及表面预留接口电路（TBD-08、09、11）。
- [ ] SCH-07：电子负载设计 DAC/模拟恒流环、MOSFET、控制分流与回读；确定近短路及开路测量可达性（TBD-13、14）。
- [ ] SCH-08：提交线性 SOA、失控持续工况、散热器/风扇、结温与限流/过温预算；不得只验额定 20W（TBD-03、13、15、16）。
- [ ] SCH-09：设计硬件 ENABLE、故障锁存、心跳超时、急停、输入隔离、反接与瞬态保护；验证 MOSFET 短路失效时的断开路径。
- [ ] SCH-10：清洁驱动、限位、堵转检测、独立供电/熔断、续流与电气/机械互锁（TBD-12、16）。
- [ ] SCH-11：在立创EDA绘制两板原理图，核对符号/封装/引脚与数据手册，开展 ERC 和逐项人工审查（TBD-17、18）。
- [ ] SCH-12：设计校准注入点和测试点，固定参考仪表/标准电阻及误差预算；执行上电前审查后再批准 PCB（TBD-19、20）。

## 当前采购核对

- [x] 登记用户已购辐照度传感器并确认 RS485；已核对 SM9569 家族手册（B 型 RS485 Modbus、DC12–24V），但实物后缀/实际配置、倍率和校准尚未验收。
- [x] 登记用户已购 50W 光伏板；此为采购事实，未将其视为满足原 10–20W 规格或已批准接入。
- [x] 登记已有 ESP32-S3 开发板、RS485 转 TTL、INA226、PT100 及 MAX31865；用户已澄清 PT100 类型，不再记为热电偶，不重复建议购买。
- [x] 更正环境仪表为用户确认的 RS485；SM7820C CAN 手册仅保留来源追溯，不作为当前实物供电/协议/采购依据，无需 CAN 模块。
- [x] 在 BOM 中区分原型验证模块、设计后采购器件和后续清洁物料，明确总原理图由本项目自行设计。
- [x] 阅读两份正确手册，记录版本/SHA-256、参数/协议及歧义；SM9569 示例 CRC 离线核对通过。误发论文按用户要求忽略，不纳入技术来源。
- [ ] SM9569 核对实际型号/线序/地址/速率，取得倍率/响应/误差定义与校准资料；TBD-09 保持未关闭。
- [x] 用户提供并确认 SM7820B V24.3.19 正确手册，已核对供电/线色图、RS485 Modbus、默认9600/8N1/地址1和双温湿度映射；实物配置、倍率/负温/无效码/响应与标定仍待TBD-08、10。
- [ ] 核对现有 RS485 转 TTL 电平/方向/参考地、开发板型号、INA226 分流/上拉/端子额定和 PT100 线制/Rref；电气/测量验收尚未执行。
- [ ] 确认是否将正式实验对象由 10–20W 改为已购 50W 板；若确认，先同步 README/AGENTS/各相关规格，再重审量程、SOA、散热/保护及供电，不沿用原功率假设。
- [ ] 获取已购光伏板型号及 Voc/Isc/系数，核实低压属性，盘点可调限流电源、万用表和示波器，避免重复采购。
- [ ] 按上述信息完成第一批可下单料号核对；ADC、负载器件、电源和清洁驱动待相应设计依据后再定。

## 2026-10-25 资料核对交付

- 已同步 BOM、传感器/硬件/架构/协议/数据字典、主板接口与验证计划；现有手册参数均标明是厂家资料，不是实测结果。
- SM9569 的 /100 只是手册假设示例，未固定为辐照度倍率；SM7820C 的标准 CAN 示例与文字/部分截图有差异，未生成可直接运行的配置。
- 资料核对本身不批准电气接线、不产生实验数据，原始 PDF 未修改；后续按用户追加要求的 Arduino 实现见下节。

## Arduino 原型接线与程序

- [x] 检查用户提供的 Arduino/siri/siri.ino：初始为空 setup/loop 模板（129 字节）；交付时保留备份。
- [x] 用户确认尚未连线并委托规划；已在主板 INTERFACES.md 给出 P1、供电/地、电平、方向控制、共线地址/终端、PT100 线制和分步验证条件。
- [x] 最初 P1 纸面验证：11 个 GPIO 无重复（此次去掉 CAN 后为 9 个候选脚），未占选定保留脚，已核对官方参考板引出；86 个本地文件链接检查无错误。此结果不代替用户实际板型/模块或通电验收。
- [ ] 实物核对板型/引出与模块电平/针脚、PT100 线制/Rref、INA226 分流，核对两只 RS485 的共线条件并按步骤验证；无通电/通信结果。
- [x] 按用户追加要求完成 P1 Arduino 原型：INA226/MAX31865/RS485；本次删除 CAN 并新增环境 Modbus 显式原码配置、原值/错误/null、时间/标识、输出背压停采；不驱动负载/清洁。不猜分流/Rref/辐照度倍率/环境负温。
- [x] 增加标准库电脑归档：准确 RX/TX 字节、解析记录、摘要/状态，禁止覆盖旧目录；不是已完成真实数据采集或备份。
- [x] 执行 C++ 协议/数学测试、2 项 Python 文件完整性测试，完成 Arduino-ESP32 3.3.11 目标编译；独立复核问题已修复。0.1.0 历史构建：Flash 364358 字节、全局 RAM 40864 字节，无项目编译诊断；无硬件实测。
- [x] 本机 x86_64 ctags 不可执行，已由官方源码在本地构建原生工具，仅经构建脚本局部覆盖；未替换全局工具，源码包/许可证/说明保留在忽略的 build/tools。
- [x] 已交付 5 个工程文件到用户 Documents/Arduino/siri，并逐文件 SHA-256/字节校验；初始 129 字节模板备份为 siri.ino.before-pv-senselab-20261025.bak，摘要与原件一致。
- [x] 对实际交付目录再编译成功：Arduino-ESP32 3.3.11、ESP32S3 Dev Module、Hardware CDC/JTAG + CDC On Boot；0.1.0 历史构建：Flash 364358 字节、全局 RAM 40864 字节，编译退出 0。51 份 Markdown、92 个本地链接/锚点复查无错误；构建工具/日志被 Git 忽略。

## RS485 环境仪表更正（2026-10-25）

- [x] 用户再次确认 SM7820C (1).pdf 为随附手册后，核对摘要未变并目视复查第 2、5、6 页：内容仍描述 CAN/250kbps；记录“实物报告 RS485 与随附手册接口冲突”，待完整型号/端子标识或厂家说明澄清。此次仅资料复核，未改代码或接线，未实测。
- [x] 删除 CAN/TWAI 驱动、命令、引脚与采购要求；GPIO4/5 不分配，原 CAN 版手册仅留来源追溯。
- [x] 两仪表共 UART1 TX17/RX18、9600/8N1，单事务轮询，分别配置地址，冲突/缺参数/寄存器越界拒绝启动；环境通道默认关闭，正确 Modbus 资料确认后才可配置原码读取。
- [x] 同步架构/硬件/传感/BOM/协议/数据字典/接线与验证计划；环境温度/湿度工程值保持 null/ENCODING_UNCONFIRMED，不宣称解码完成。
- [x] C++ 测试通过（多字/FC03/04/坏帧/CRC/地址冲突），Python 2 项测试通过；目标构建退出 0，Flash 356998 字节、全局 RAM 40840 字节，无项目编译诊断；独立源码复审未发现实质问题。
- [x] Arduino/siri 五个文件同步后字节一致，保存更正前五份 .before-rs485-20261025.bak 和最初模板备份；文档本地链接/锚点与 9 个候选 GPIO 检查通过。
- [x] 原环境解码阻塞由 SM7820B 正确手册解除，0.3.0实现情况见下一节；倍率/负温确认与实物采集/标定仍待执行。

## SM7820B 正确手册与驱动（2026-10-25）

- [x] 阅读V24.3.19/10页并核对SHA-256，目视p.4及p.7–8；原始PDF未修改。p.7查询及正文回复CRC正确，表格回复CRC不符；p.8“补码”与减65535算式相差一个count，已记录而非照抄。
- [x] 同步SENSOR/API/DATA/HARDWARE/BOM/架构/接线与验证计划；供电DC5–24V、线色图、9600/8N1/默认地址1、FC03/PDU0及1已登记，实物仍未验收。
- [x] 固件0.3.0：SM7820B默认候选双字映射，所有通道仍关闭；env_scale显式设置后才换算，env_signed_temp确认标准补码才解负码；温湿度独立状态/范围/null、严格CRC/错误映射门禁，保留原帧与配置，无写仪表操作。
- [x] C++协议/转换测试和Python2项归档测试通过；Arduino-ESP32 3.3.11目标构建退出0，无项目编译诊断，Flash358478字节、全局RAM40856字节。独立只读复核未发现实质缺陷；无硬件测试。
- [x] 五个工程文件已同步到用户Arduino/siri，逐字节一致；更新前版本逐文件保存为 .before-sm7820b-20261025.bak，历史备份保留。92个本地链接/锚点通过，PDF摘要未变。
- [ ] 逐台核实真实地址并配置不同地址后共线，核对RS485模块电平/方向/供电/接地/终端。
- [ ] 以厂家说明/参考源确认倍率及负温编码、无效码/响应和温湿度性能；未确认前保留null，尚无实测准确度或通信结果。

## Arduino IDE ctags 编译失败修复（2026-10-25）

- [x] 阅读用户两份完整日志，确认XIAO及通用S3选项均在ctags生成原型时失败，尚未进入串口上传；ARM64主机调用x86_64工具可重复报bad CPU type in executable。
- [x] 备份后将用户Arduino15内故障ctags替换为此前官方源码构建并验证的ARM64版本；Intel原件、源码/许可证及SHA-256修复摘要保留在工具目录。没有修改系统工具、安装Rosetta或改动固件逻辑。
- [x] 按最新日志esp32:esp32:esp32s3默认配置，直接CLI编译Documents/Arduino/siri，无ctags路径覆盖；退出0，Flash354038字节、全局RAM40664字节，无项目编译诊断，日志在忽略的build/ide-default-compile.log。
- [ ] 核对实际开发板/模组及USB插口，确认IDE板卡/Flash/PSRAM/CDC与端口；软件选择记录不是实物确认，不把XIAO的D编号套入P1 GPIO。
- [ ] 实际上传/串口通信尚未执行；当前只确认阻塞编译的问题已修复，无硬件验证结论。

## 实际串口与MAX31865首笔故障修复（2026-10-25）

- [x] 用户报告上传成功，IDE上传日志显示Hash verified；115200/8N1状态查询及监视器显示正常JSON，固件0.3.0。先前乱码未稳定复现，随后重启原始流仍含一条非JSON启动行，保留而不丢弃，不据此认定所有串口问题消失。
- [x] INA226未连接，保持禁用。两只RS485均未改出厂地址1，未启用轮询、未发送地址修改；用户只确认外部电源关闭，尚未确认单仪表隔离或授权改址。
- [x] 0.3.0首次三线RTD诊断首笔configuration_readback_failed、随后4笔原码25240–25241、fault=0、Rref未知温度null。全部收发/解析/摘要在data/raw/bench/serial-diagnosis-20261025-01、02-status、03-rtd，摘要已重算匹配；非标定/正式实验。
- [x] 根因证据：本机Arduino-ESP32 3.3.11数字写接口要求已注册GPIO；旧代码CS先digitalWrite后pinMode，HIGH被忽略，SPI初始化时器件未可靠取消选中。0.3.1改为先pinMode再置CS高，手动RS_DIR亦先配置再置接收态；配置错误保留期望/实读寄存器并尝试关闭偏置。
- [x] C++关键逻辑测试、Python2项归档测试、独立源码复核通过；通用S3默认配置编译退出0，Flash354190字节、全局RAM40664字节。已备份同步五文件，实际上传并校验通过（build/spi-cs-fix-compile.log及upload.log）。
- [x] 重启后首次与随后4笔RTD均配置读回通过、config=145/fault=0，原码25225–25228，温度继续null；初次配置故障在该次5笔验证未复现。data/raw/bench/serial-diagnosis-20261025-04-rtd-cs-fix共7998字节、13个合法JSON、1条启动非JSON，完整保留且摘要匹配。
- [x] 恢复IDE监视器115200，status确认0.3.1、streaming=false、四通道均关闭；未把fault=0当温度准确度合格。
- [x] 用户恢复外置电源后独立复核RTD：05-rtd-power-restored共7776字节/14合法JSON/0坏行，5笔原码25223–25225，config145/fault0，Rref未知温度null；收发及摘要保留，已stop。此结果不确认探头接法或实际温度准确。
- [ ] 核对MAX31865实物正反面/参考电阻、三线跳线与探头接线，再做电阻/温度参考验证；当前有原码不等于完整测温可用。
- [x] SM7820B已独立从1改2并严格读回，见16成功记录；set env_address仍仅配置主站目标，不是设备改址。

## 温湿度受限改址准备与实际尝试（2026-10-25）

- [x] 用户明确授权地址1改2，并确认当前单独连接温湿度传感器；按SM7820B p.8固定PDU0x0066、FC06、仅写值2，增加commission_env_1_to_2 single_device维护例外；普通采集仍只读。
- [x] 0.4.0门禁：停止且四通道禁用、显式方向/SM配置；先读旧址寄存器值1，最多写一次，新址CRC有效且读回值2才verified；每阶段250ms，记录原帧/回显，不提供其他写操作或自动重写。主站env_address默认2仅为计划查询目标，不表示设备已改址。
- [x] 协议/数学测试及Python2项归档测试通过，独立源码复核通过；目标构建退出0，Flash355986字节、全局RAM40664字节；已备份同步并上传校验通过，日志在build/address-commission-*。
- [x] 实际改址预检失败：06-env-address-change读取1号PDU0x66无返回、precheck_failed_no_write，没有进入write_once；2355字节/3合法JSON/1启动非JSON均保留且摘要匹配。设备未被本次操作改址，不能报成功。
- [x] 普通数据只读核查：07-env-readonly-probe对1号和2号各发两次FC03/PDU0/数量2，四次均timeout且response_hex为空；9738字节/19合法JSON/0坏行，结束全部禁用/停止，摘要匹配。
- [x] 较早RS485无应答已通过TX18/RX17方向更正读通；后续严格地址修改成功见16，默认2重启复查见18。模块电平/保护/启动暂态仍不作验收声明。

## 后续研发队列

- [ ] 第 2 周完成原理图评审、BOM 与 PCB 约束冻结；采购与制造依实际资源调整。
- [ ] 第 3 周完成样机分段上电、保护注入和测量链标定。
- [ ] 第 4 周实现并验证数据采集、协议、扫描与特征提取。
- [ ] 第 5 周实现单二极管受约束估计、辨识性与误差评价。
- [ ] 第 6 周执行因素实验与清洁复测闭环。
- [ ] 第 7 周独立复测、复现归档与论文草稿。

各项以 [ROADMAP](docs/ROADMAP.md) 的证据门槛为准。无硬件、无标定、阈值未冻结或无真实记录时不得勾选。拟合/诊断尚无准确率指标，实验重复数和统计判据见 TBD-21、22、23。

## 第一阶段验收记录

- 文件/相对链接/锚点/TBD 索引/需求及周次检查：已执行，无缺失或悬空引用。
- Git：`main` 仓库已初始化，尚无提交；初始目录为空，没有覆盖或迁移旧文件。
- 忽略策略：原始大数据、运行附件、构建与虚拟环境被忽略；目录 README、标定 JSON/CSV、元数据、EDA 源和硬件故障日志不被误忽略。
- 人工一致性复核：明确 DUT 输出测量平面、外置电阻损耗含义、端点资格、只读初始校准、故障安全与原始记录保留。
- 未执行：构建、固件/算法功能测试、原理图/PCB 检查、上电、标定、扫描、实验和恢复评价。本阶段无相关实现或硬件，不能据此宣称性能通过。
- 结论：本次结构与规格交付通过；规格为待评审草案，技术冻结及后续硬件/科研验收仍未完成。

## 所购模块UART方向更正（2026-10-25）

- [x] 用户提供所购商品说明，明确TX-TX/RX-RX直连；既有TXD→18、RXD→17与旧程序方向不符。0.4.1改为TX18/RX17，保留现有线；默认env_address恢复1，设备实际改址仍以读回为准。
- [x] 0.4.1方向更正已编译、备份同步、上传并只读读通；地址变更结果见下，不能据此勾选改址成功。
- [ ] 关闭TBD-04/10：照片MAX485厂家5V±5%与商品3.3V声明冲突，实物版本/输出电平/输入阈值/接地/保护/热仍待核对；不盲改5V，不凭商品图作电气放行。

- [x] 0.4.1实物：编译/上传校验通过（Flash355986、RAM40664）；08-uart-direction两笔温湿度均frame_ok、CRC有效，原码[2626,5932]及[2630,5925]，倍率未确认故工程量null；结束停止且全禁用。09维护预检仍以01查询0x66无回复，未写入。
- [x] 复核SM7820B p.8：指定FA通用查询地址，回复采用实际地址；0.4.2改用该只读请求，保持应答地址/值双验证。手册字节夹具在修改前失败。
- [x] 0.4.2构建/上传校验通过，FA预检无应答，未发送写；随后以普通采集作对照，不把首次超时判为寄存器不支持。

- [x] 0.4.3普通数据预检首笔仍超时；12普通采集对照同一固件首笔timeout、第二笔frame_ok（原码2628/5935），确认需处理启动首事务失败，具体电气原因未定。
- [x] 0.4.4前后各最多3次只读校验，写仍最多一次；C++协议/数学与Python2项测试通过，目标构建Flash356150/RAM40664、上传校验通过；五文件同步且备份保留。
- [x] 13实际前检第1次timeout、第2次CRC正确；仅发一次010600660002E814，写回无应答，2号三次读均无返回，outcome_unknown_do_not_repeat_write。14后续仅只读：1号首笔timeout、第二笔CRC正确（2623/5929），2号两次timeout。当前观察仍在地址1，改址未成功，未重复写。
- [x] 13-env-bounded-commission: 4876字节/8合法JSON/1坏行，三个文件SHA256匹配；14-post-write-readonly: 9788字节/19合法JSON/0坏行，三个文件SHA256匹配。失败与原始字节均保留，不把程序目标地址或已发写帧当成功。
- [ ] 后续核对实际模块芯片/供电与双向TTL波形、仪表配置通信条件和事务间隔；在只读确认旧/新地址后再决定是否需要新的受控改址尝试，不循环写入。两只仍不得同址共线。

## 12V确认后的只读对照（2026-10-25）

- [x] 用户确认温湿度外置电源12V（名义值在SM7820B手册范围）；不代表纹波/启动/预算实测，不改变TTL模块3.3V。
- [x] 15只读对照：0x66共4次，第1次timeout、后3次frame_ok且返回地址1/寄存器值1；普通100ms周期47笔frame_ok、1笔启动timeout、1笔结束cancelled。未发送设备写命令。不能由此前首笔超时认定寄存器不支持。
- [x] 0.4.5恢复严格地址寄存器前后验证，维护请求前保守空闲100ms，前后只读最多3次，写最多一次；字节/值校验测试先失败再修正。最小可靠间隔及首事务问题原因仍未判定。
- [x] 0.4.5构建/上传校验通过（Flash356142、RAM40664），16旧址0x66读回1、仅写一次、2号0x66读回2且CRC有效，verified_1_to_2；3919字节/6合法JSON/1启动坏行，三个文件SHA256匹配。

- [x] 17独立只读复查：1号两次timeout，2号首笔timeout、第二笔frame_ok，原码2630/5908；9788字节/19合法JSON/0坏行，三个文件摘要匹配；已停止并关闭所有通道。
- [x] 0.4.6仅同步主站默认envAddress=2，不增加设备写入；源码/文档留存历史失败和实际成功，倍率与标定不作成功声明。
- [x] 0.4.6构建/上传校验通过（Flash356142、RAM40664）；18在ESP32重启后未发送set env_address，以默认2读到CRC有效温湿度帧，结束streaming=false、四通道禁用；5596字节/8合法JSON/1启动坏行，三个文件SHA256匹配。交付五文件与主源字节一致。
- [ ] 传感器外置12V断电保持、辐照度1号和双从站共线另行验证；倍率/标定、模块电平和启动首事务超时原因仍待核对。

## 双RS485恢复供电与共线验证（2026-10-25）

- [x] 用户报告接回辐照度A/B并恢复电源；19只读核对2号0x66共4次均CRC有效、值2，支持本次用户报告的断电恢复后地址保持，不等于重复掉电寿命验证。
- [x] 19共线原始证据：1号11次CRC有效、原码0（倍率未知不能称0W/m²）；2号6次frame_ok/5次timeout。间隔约10ms，当前不能判共线稳定；无设备写命令，已停止/禁用。
- [x] 0.4.7只将普通事务空闲由10ms改100ms，维护共用同一常量；无量程/引脚/供电或执行器变化，电平/接地/保护/SOA热与校准TBD保留。
- [x] 0.4.7编译/上传校验通过（Flash356142、RAM40664），C++协议/数学及Python2项归档测试通过；五文件与Arduino交付字节一致、修改前已备份。

- [x] 19原始归档32455字节/51合法JSON/0坏行，三个文件摘要匹配。20同接线改为100ms空闲后，约20.184秒数据轮询：1号21/21有效（原码0）、2号21/21有效（末笔2589/6029），均无数据超时/CRC错误；最小实测事务间隔100.877ms。此前地址寄存器检查首笔timeout、随后3次CRC正确值2，未隐藏该错误。
- [x] 20归档：50204字节/70合法JSON/1启动非JSON，三个文件SHA256匹配，独立CRC/原码解析通过；无commission设备写命令；结束streaming=false且四通道全禁用。支持本次共线短测与用户报告恢复供电后地址2保持，不代表长期稳定/精度/电气保护验收。
- [ ] 下一步确认SM9569/SM7820B工程倍率与负温定义，核对PT100/MAX31865参考电阻及三线跳线；INA226保持未接禁用。模块3.3V电气余量和启动首事务超时原因、长期/重复断电验证仍待核对。

## 温度探头类型再次核对（2026-10-25）

- [x] 用户后续明确为PT100贴片型、商品2B级及MAX31865；类型冲突已关闭，转为核对参考电阻与三线补偿。
- [x] 本次仅复查资料与既有记录，未启用未知类型探头、未更改驱动/接线或猜测Rref；MAX31865原码记录不能作为热电偶温度。

## PT100模块图与三线模式对照（2026-10-25）

- [x] 用户再次明确探头为PT100贴片型、商品标“2B级”，配MAX31865；不再按热电偶选驱动。“2B级”的标准/公差和证书待厂家说明。模块图Rref标431，对应标称430Ω；实物精密值/温漂未校准。用户确认中间选择焊盘连3且断开2/4，同端两线接F+/RTD+、负端短接、正端2Wire断开，探头在室温未加热；实际导通阻值未提供。
- [x] 21三线模式5笔rtd_code25217–25218/config145/fault0，8556字节/16合法JSON/0坏行；22同接线二线模式5笔8390–8392/config129/fault0，8949字节/17合法JSON/0坏行；均原始摘要匹配、工程温度null，结束停止且软件配置恢复三线。
- [x] 独立官方驱动软件SPI对照完成：MAX31865 1.6.2固定提交02dd3393d9750ca6e227be84b0e3b795a6941c36、BusIO1.17.4，三线25216–25220、二线8391–8393，fault0；没有凑值修正或新增生产依赖。已用保存的原二进制恢复0.4.7且上传校验通过，原始源/交付5文件相同。

- [x] 23归档5488字节/10合法JSON/1坏行，三个文件摘要匹配；解析记录三线4笔、二线5笔及完成事件。第一笔三线JSON前接启动字节，原始文件完整保留，另在data/processed/diagnostics/20261025-reference-prefix-recovery.json以源摘要/字节偏移派生恢复，不修改原始数据或补造主机收时。合计实际三线5笔、二线5笔。
- [ ] 待补实物正面跳线/端子近照，或断电后的中间↔3、中间↔2/4、3↔F+阻值及参考电阻/标准电阻检查，区分实际补偿通路与板/芯片行为。用户确认接线正确，但尚无这些电气证据；三线测温未通过，不把约26°C参考换算当准确度结论。

## 三线选择焊桥改动后复测（2026-10-25）

- [x] 用户报告将标3侧与中间短接并要求复测；未改固件，24按三线模式采5笔：rtd_code依次1/1/0/0/1，config145，fault依次0/0/64/64/0，工程量均null。8460字节/16合法JSON/0坏行，三个文件SHA256匹配；结束停止、关闭偏置且全通道禁用。
- [ ] 复测不通过。此前三线约25217，补焊后0–1并出现0x40低阈值故障，与三线选择中间到2/4原有接地桥仍连通、补焊后F+接地的假设相符；尚不能直接判定具体焊点。已要求先断USB和12V，核对2/4↔中间选择桥，保留中间↔3桥；探头线不要求改动。实际导通/实拍仍待确认。禁止启用430Ω温度输出或把0原码当0°C。

## 默认选择桥尝试切断后复测（2026-10-25）

- [x] 用户报告2/4与中间“好像断开”，25三线复测5笔rtd_code11264/11269/11258/11264/11267，config145、fault均0；Rref仍未配置、温度null。按标称430Ω约148Ω，与此前室温条件不符，不判通过。25结束状态确认停止且全禁用。
- [x] 26同接线二线原码对照未收到任何RX字节；27仅两次status查询也0字节，不能当测量结果。系统仍列出同一USB串口，未发现监视器或其他读者占用。官方esptool只读MAC/硬复位尝试退出2、No serial data received，日志build/pt100-status-recovery.log；未写Flash。
- [x] 25-pt100-after-default-bridge-cut：8508字节/16合法JSON/0坏行，三个文件摘要匹配；26-pt100-two-wire-after-bridge-cut：0字节/0合法JSON/0坏行，三个文件摘要匹配；27-status-after-empty-control：0字节/0合法JSON/0坏行，三个文件摘要匹配。空采集的complete仅表示主机记录结束，不代表通信或测试成功。
- [x] 用户重新插USB并按EN后，28收到有效0.4.7状态：停止、四通道关闭，主控通信恢复；此前无应答具体原因未定，不能判PT100/模块损坏。

## 主控恢复后的PT100模式对照（2026-10-25）

- [x] 29同接线三线模式5笔：11195–11216、config145/fault0；30二线模式控制5笔：8390–8394、config129/fault0。均未配置Rref、温度null；按图标称430Ω仅作诊断计算，前者约147Ω、后者约110.1Ω，异常仍随三线补偿开启出现，不据此判定某个焊点。
- [x] 28-status-after-user-reset：1605字节/1合法JSON/1坏行，三个文件摘要匹配；29-pt100-three-wire-after-user-reset：8510字节/16合法JSON/0坏行，三个文件摘要匹配；30-pt100-two-wire-after-user-reset：8913字节/17合法JSON/0坏行，三个文件摘要匹配。30结束状态确认停止、所有通道关闭且软件设置恢复三线；未修改固件/地址，不继续切线或追加温度换算。
- [ ] 待用户提供当前已焊、已切选择桥的实物正面近照，覆盖三焊盘、切口、Rref及四个探头端子；或提供实测导通/已知电阻结果，再定位三线补偿通路。暂无证据完成三线测温验收。

## PT100已焊切实物照片检查（2026-10-25）

- [x] 收到实际模块照片并放大检查，原图/来源摘要追加归档data/raw/bench/20261025-pt100-physical-inspection。左2/3Wire可见加焊，右2Wire未见明显焊锡桥，三焊盘选择区可见焊锡与切割痕迹；反光/助焊剂遮挡，无法凭照片确认中间到3导通或2/4隔离。实际Rref字码不清，430Ω仍仅此前商品图的标称依据，未测实物精密值。
- [ ] 上方叉形端子遮住进线孔，不能可靠断言中间红线插入第2或第3孔；按正面从左F−/RTD−/RTD+/F+，需确认同端两线分别位于右侧RTD+/F+，另一根在已短接负端。检查叉片是否确实压在金属夹线位置、是否碰邻端，不凭外观判定已接错。
- [ ] 断电确认中间↔3和3↔F+近0Ω、中间↔2/4非近0Ω；仍无实际阻值。没有新增切割、焊接、固件改动或上电测试；三线测温继续待验证。

- [x] 用户报告断电测量“三焊盘中间↔F+”为0Ω，支持该外部选择桥到F+连通；不再要求改该焊桥。该测量尚不能证明芯片FORCE2引脚完整通路或探头同端引线/接触。
- [ ] 下一项最小检查：探头保持连接、USB及12V断开，测F+↔RTD+实际阻值。两根同端引线应主要呈引线环路电阻，板上2Wire焊桥仍保持断开；用该值先核对同端回路与端子接触，不继续割线或猜温度。

- [x] 用户报告断电、保持探头连接时F+↔RTD+为0Ω、RTD+↔RTD−为100Ω；按用户原话记录，尚未取得含小数/单位的屏幕完整读数，不把100取整值当精密测量。支持探头同端回路和感温支路存在，不据此关闭三线补偿异常。
- [ ] 当前实物图芯片封装/1脚方向与Rref字码不能可靠确认，暂不指导探测细脚；先取得RTD支路完整表读数与标Rref电阻两端断电在板读数。430Ω仍是此前商品图标称依据，不能由期望室温反推或凑值。Rref在板读数只作排查，不当精密标定。

- [x] 用户补充表读：RTD+↔RTD−为113Ω、Rref两端为428Ω（按用户报告，断电在板测量，非精密校准）。此前100Ω报告被补充为113Ω，430Ω仍为商品图名义值；不把异时表读与此前ADC视作同一热状态，不据此认定出厂损坏。
- [ ] 当前只能确认三线补偿读数异常；官方驱动复现，但芯片FORCE2完整通路、参考电阻/已知正常模块的对照仍缺失。模块已焊/切，不能据当前状态区分出厂缺陷与改动/接触影响；暂停追加割线/补焊，需进一步对照或厂家核查。

## 使用现有模块的参考测温模式（2026-10-25）

- [x] 用户明确要求继续使用唯一模块完成采集，不再割焊；0.5.0新增独立rtd_compensation开关，保留三根物理线，关闭D4时标reference_uncompensated与LEAD_RESISTANCE_UNCOMPENSATED。Rref采用用户报告428Ω但未校准；不除3、不伪造输出。配置位单元用例在实现前因接口缺失失败。
- [x] 0.5.0构建Flash356502/RAM40664，C++协议/转换与Python2项归档测试通过；备份同步五文件字节一致，上传校验通过。31实物参考模式：11笔，rtd_code8388–8391，参考温度24.54997–24.65096°C；14654字节/23合法JSON/1启动非JSON，fault均0/config129，物理线3、补偿false、Rref428，reference_uncompensated及LEAD_RESISTANCE_UNCOMPENSATED/UNCALIBRATED完整。独立换算与原始三文件SHA256均匹配，结束停止/全禁用。

- [ ] 参考模式可用于台架观察，三线补偿故障仍未修复；参考电阻精密校准、引线/接触误差、同步参考温度/动态响应与准确度尚未验证。不得用本次约24.6°C参考值宣称三线测温验收。

## ESP32内嵌四指标网页（2026-10-25）

- [x] 用户授权ESP32内实时折线/统计页面，并强调匹配光伏科研场景；三个传感器四数据，INA未接关闭。已建立docs/WEB_DASHBOARD_SPEC.md，选择无CDN单页/SoftAP/WebServer/Canvas/有界缓存及只追加原始Flash归档。
- [x] 完成光伏退化/寿命研究定位的概念图与离线双语页面；规范G/T_a/RH_a/T_RTD，未知倍率count，原始JSON字段稳定，无虚构预测。
- [x] 0.6.0实现SoftAP/WebServer、1024点派生缓存/样本统计、LittleFS只追加JSONL、受控启动停止/原子配置、CSV/JSONL导出；没有负载/清洁/改址Web接口。
- [x] 缓存/统计C++、原协议数学C++、Python2项归档、Node双语/历史/CSV逻辑验证通过。构建Flash1038285/RAM106064；备份同步8文件一致，上传及Flash校验通过。
- [x] 32-web-dashboard真实HTTP验证：四通道各18有效/0异常；PT100参考24.48264–24.51631°C，前三路倍率未知保留count。分页、配置拒绝/接受、令牌/方法/路径限制、原始下载62记录50734字节通过；独立重算统计与全部证据SHA256匹配。结束采集停止，电脑原Wi-Fi恢复。
- [x] IAB验证本地同版中英页面与设置、390×844手机无横向溢出；1435×1096原尺寸核对，view_image并排审查概念/实现，详见docs/design/VERIFICATION.md。用户明确保留热点模式，不加入路由器网络。
- [ ] 实机网页完整交互/截图尚未通过自动浏览器权限审查（超时，非安全否决）；没有将本地空态截图当实机曲线。存储满/写故障注入、断电尾部/非空未知分区恢复、长时运行与独立备份恢复未验收。
- [ ] 确认辐照度与温湿度实际倍率/标定、PT100三线补偿及精密标定、探头/辐照仪安装条件。寿命预测还需电气/I–V、长期退化数据、基线、寿命终止准则及不确定度验证。

## 学生源码分发包（2026-10-25）

- [x] 用户报告手电照射时辐照度原码有变化，登记为现场光响应观察；没有新增原始归档，不作倍率/准确度标定结论。
- [x] 打包releases/PV-SenseLab-ESP32S3-v0.6.0-20261025.zip：23文件，包含原Arduino代码、网页源码、生成/归档工具、确定性测试、相关协议与学生说明、MANIFEST和包内验证记录；不含实验原始数据、运行密码、日志、二进制固件或构建缓存。7个代码文件与当前Arduino交付副本一致。
- [x] 从独立解压目录重新生成网页无字节变化，C++两套编译/运行、Python2项、Node双语/缓存/CSV与归档help通过；Arduino-ESP32 3.3.11通用S3构建退出0，Flash1038285/RAM106064。最终ZIP CRC、无重复路径、逐文件SHA256及源码一致性再次通过，另有整包.sha256。
- [x] 本次未重新上传、复位设备或改引脚/采集逻辑；未向学生发送消息，由用户转发压缩包。硬件/标定/长期运行和寿命算法等未决项不因源码分发而关闭。

## GitHub首次上传与SSH配置（2026-10-28）

- [x] 用户授权上传至yolkytygyfse-a11y/pv-senselab；已核实本地main尚无提交、未配置remote，目标仓库公开且报告size=0。现有gh身份zhengyongxiong没有目标仓库写权限，旧SSH身份不等于目标账号，不改原有账号配置。
- [x] 创建本机项目专用Ed25519密钥，私钥仅存~/.ssh、权限600；仅公钥副本位于被忽略的releases/pv-senselab-github-ssh.pub，公私钥均不进入项目提交。用户已将公钥添加至目标账号，SSH返回Hi yolkytygyfse-a11y；项目单独指定密钥，未修改全局Git/SSH账号配置。
- [x] 首次上传候选清单已检查：73个项目源码/规格/说明文件，无实验原始记录、私钥、已识别令牌、构建缓存或分发ZIP；Python两项、Node双语/缓存/CSV、C++协议/数学与统计/缓存测试重新运行通过。
- [x] GitHub目标账号公钥绑定与SSH身份验证通过，普通push -u origin main成功（无force）。已核对首个提交7e4a440f00eb5038606de1ab21709b3ca0c10625与远端main一致；工作区干净、main跟踪origin/main。仓库：https://github.com/yolkytygyfse-a11y/pv-senselab。

## 英文项目首页与愿景说明（2026-10-28）

- [x] 按用户要求将README改为英文科研工程叙述，明确多物理观测+实际电气功率→健康/退化→长期寿命评估的愿景，列出当前传感采集、下一阶段功率/基线、后续I–V/辨识与长期数据门槛；不写招生宣传口吻或未经确认的个人贡献。
- [x] 通过电子测量、嵌入式资源与通信取舍、单二极管/工作点和最大功率理论、辨识性、混杂控制、维护耗水/耗能与证据边界体现学科交叉；相关模型公式已对照Sandia/pvlib与器件官方文档。没有新增已完成功能或效果承诺。
- [x] 用户明确授权公开的运行截图原样保存为docs/design/pv-dashboard-bench.png，图注披露前三通道原码与PT100未补偿/未校准；与原附件SHA256一致，未修改数据。独立归档文件、密钥和密码保持不发布。
- [x] README的26个本地链接/图片目标存在，显示数学分隔符配对，git diff --check通过；本次只改文档/展示资产，固件与运行逻辑未改，不将既有测试结果当成本次硬件实测。
- [x] 使用GitHub官方Markdown接口渲染检查通过：13个标题、1张授权实机截图引用、4个math-renderer元素（含3段展示公式）；没有改变传感器显示值或运行程序。
